X-Microsystems/xmicro-serial/README.md

# XMICRO-SERIAL

[XMICRO](https://github.com/x-microsystems/xmicro-bus) serial communications card providing two RS-232 ports and a PS/2 port.

Datasheet: [XMICRO-SERIAL](Documentation/XMICRO-SERIAL.pdf)

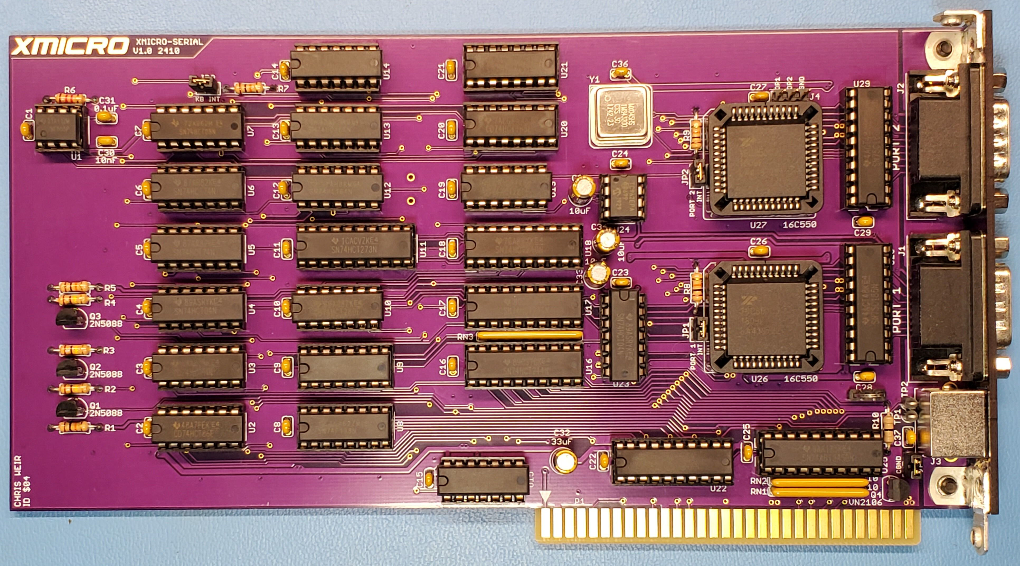
[picture p1: Images/XMICRO-SERIAL 1.jpg]
XMICRO-SERIAL
