X-Microsystems/xmicro-serial/Documentation/Schematics/Netlist.txt

Netlist

Exported from XMICRO-SERIAL V1.0.sch at 2024-09-08 19:48:15

EAGLE Version 6.3.0 Copyright (c) 1988-2012 CadSoft

Net      Part     Pad      Pin        Sheet

!BCSX    P1       9        !CSX       4
         U22      2        A          4

!BIRQX   P1       52       !IRQX      4
         Q4       3        D          6

!BRD     P1       19       !RD        4
         U22      4        A          4

!BRST    P1       10       !RST       4
         U15      5        I          4

!BWR     P1       20       !WR        4
         U22      17       A          4

!CSX     U22      18       Y          4
         U25      19       !OE        4
         U26      16       !CS2       1
         U27      16       !CS2       1
         U8       4        G2A        5
         U9       4        G2A        5

!CS_IDR  U16      1        !OE        5
         U16      19       !OE        5
         U9       7        Y7         5

!CS_KBR  U14      3        CLK        2
         U18      1        !OE        2
         U18      19       !OE        2
         U9       15       Y0         5

!CS_KBW  U20      1        SH/!LD     3
         U21      1        SH/!LD     3
         U5       10       PRE        3
         U5       3        CLK        3
         U8       15       Y0         5

!CS_STR  U17      1        !OE        5
         U17      19       !OE        5
         U9       14       Y1         5

!KB_DATA U12      1        A          2
         U15      12       O          2
         U3       9        I0         3

!KB_INT_ENABLE U23      13       I          2
         U26      38       !OP1       1

!KB_WRCYCLE U12      2        B          2
         U13      2        B          2
         U20      15       INH        3
         U21      15       INH        3
         U5       6        !Q         3

!RD      U22      16       Y          4
         U25      1        DIR        4
         U26      24       !IOR       1
         U27      24       !IOR       1
         U9       5        G2B        5

!RST     U11      1        CLR        2
         U15      2        O          4
         U5       13       CLR        3
         U6       1        CLR        2
         U7       1        I0         2
         U7       4        I0         2

!WR      U22      3        Y          4
         U26      20       !IOW       1
         U27      20       !IOW       1
         U8       5        G2B        5

+5V      C1       1        1          6
         C10      1        1          6
         C11      1        1          6
         C12      1        1          6
         C13      1        1          6
         C14      1        1          6
         C15      1        1          6
         C16      1        1          6
         C17      1        1          6
         C18      1        1          6
         C19      1        1          6
         C2       1        1          6
         C20      1        1          6
         C21      1        1          6
         C22      1        1          6
         C23      1        1          6
         C25      1        1          6
         C26      1        1          6
         C27      1        1          6
         C28      1        1          6
         C29      1        1          6
         C3       1        1          6
         C32      +        +          6
         C36      1        1          6
         C37      1        1          6
         C4       1        1          6
         C5       1        1          6
         C6       1        1          6
         C7       1        1          6
         C8       1        1          6
         C9       1        1          6
         J3       4        4          2
         P1       5        +5V        4
         P1       6        +5V        4
         R1       2        2          2
         R5       2        2          2
         R6       1        1          3
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
         C9       2        2          6
         J1       5        5          1
         J2       5        5          1
         J3       3        3          2
         J4       1        1          1
         JP4      1        1          6
         P1       21       0V         4
         P1       3        0V         4
         P1       4        0V         4
         P1       42       0V         4
         P1       62       0V         4
         Q1       1        E          3
         Q2       1        E          2
         Q3       1        E          3
         Q4       1        S          6
         R7       2        2          6
         R8       1        1          6
         R9       1        1          6
         U1       1        GND        3
         U10      1        G          2
         U10      7        0V         * none *
         U11      10       0V         * none *
         U12      7        0V         * none *
         U13      7        0V         * none *
         U14      7        0V         * none *
         U15      7        0V         * none *
         U16      10       0V         * none *
         U16      11       A          5
         U16      13       A          5
         U16      15       A          5
         U16      17       A          5
         U16      2        A          5
         U16      6        A          5
         U16      8        A          5
         U17      10       0V         * none *
         U17      17       A          5
         U17      2        A          5
         U17      4        A          5
         U18      10       0V         * none *
         U19      7        0V         * none *
         U19      8        A          3
         U2       7        0V         * none *
         U20      5        G          3
         U20      6        H          3
         U20      8        0V         * none *
         U21      8        0V         * none *
         U22      1        !OE        4
         U22      10       0V         * none *
         U22      19       !OE        4
         U23      7        0V         * none *
         U24      3        0V         1
         U25      10       0V         * none *
         U26      21       IOW        1
         U26      22       0V         * none *
         U26      25       IOR        1
         U26      28       !AS        1
         U27      21       IOW        1
         U27      22       0V         * none *
         U27      25       IOR        1
         U27      28       !AS        1
         U28      11       0V         1
         U29      11       0V         1
         U3       7        0V         * none *
         U4       7        0V         * none *
         U5       7        0V         * none *
         U6       7        0V         * none *
         U7       7        0V         * none *
         U8       8        0V         * none *
         U9       8        0V         * none *
         Y1       4        0V         1

A0       U22      5        Y          4
         U26      31       A0         1
         U27      31       A0         1
         U8       1        A          5
         U9       1        A          5

A1       U22      14       Y          4
         U26      30       A1         1
         U27      30       A1         1
         U8       2        B          5
         U9       2        B          5

A2       U22      7        Y          4
         U26      29       A2         1
         U27      29       A2         1
         U8       3        C          5
         U9       3        C          5

A3       U22      12       Y          4
         U23      1        I          1
         U27      14       CS0        1

A4       U22      9        Y          4
         U23      3        I          1
         U8       6        G1         5
         U9       6        G1         5

BA0      P1       22       A0         4
         U22      15       A          4

BA1      P1       23       A1         4
         U22      6        A          4

BA2      P1       24       A2         4
         U22      13       A          4

BA3      P1       25       A3         4
         U22      8        A          4

BA4      P1       26       A4         4
         U22      11       A          4

BUFF_KB_CLOCK U12      8        CLK        2
         U13      8        CLK        2
         U15      8        O          2
         U20      2        CLK        3
         U21      2        CLK        3
         U4       11       I          2
         U5       11       CLK        3

CGND     J1       S1       S          1
         J1       S2       S          1
         J2       S1       S          1
         J2       S2       S          1
         J3       G$1      SHIELD     2
         J3       G$2      SHIELD     2
         J3       G$3      SHIELD     2
         JP4      2        2          6

D0       RN3      2        2          4
         U16      18       Y          5
         U17      18       Y          5
         U18      18       Y          2
         U19      1        G          3
         U20      4        F          3
         U25      18       B1         4
         U26      2        D0         1
         U27      2        D0         1

D1       RN3      3        3          4
         U16      3        Y          5
         U17      3        Y          5
         U18      3        Y          2
         U19      13       F          3
         U20      3        E          3
         U25      17       B2         4
         U26      3        D1         1
         U27      3        D1         1

D2       RN3      4        4          4
         U16      16       Y          5
         U17      16       Y          5
         U18      16       Y          2
         U19      2        H          3
         U20      14       D          3
         U25      16       B3         4
         U26      4        D2         1
         U27      4        D2         1

D3       RN3      5        5          4
         U16      5        Y          5
         U17      5        Y          5
         U18      5        Y          2
         U19      12       E          3
         U20      13       C          3
         U25      15       B4         4
         U26      5        D3         1
         U27      5        D3         1

D4       RN3      6        6          4
         U16      14       Y          5
         U17      14       Y          5
         U18      14       Y          2
         U19      11       D          3
         U20      12       B          3
         U25      14       B5         4
         U26      6        D4         1
         U27      6        D4         1

D5       RN3      7        7          4
         U16      7        Y          5
         U17      7        Y          5
         U18      7        Y          2
         U19      4        I          3
         U20      11       A          3
         U25      13       B6         4
         U26      7        D5         1
         U27      7        D5         1

D6       RN3      8        8          4
         U16      12       Y          5
         U17      12       Y          5
         U18      12       Y          2
         U19      10       C          3
         U21      6        H          3
         U25      12       B7         4
         U26      8        D6         1
         U27      8        D6         1

D7       RN3      9        9          4
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
         U1       5        CON        3

RST      U15      1        I          4
         U15      6        O          4
         U26      39       RESET      1
         U27      39       RESET      1

UC4      U11      8        D4         2
         U12      10       QE         2
