X-Microsystems/xmicro-serial/Images/XMICRO-SERIAL 2.jpg

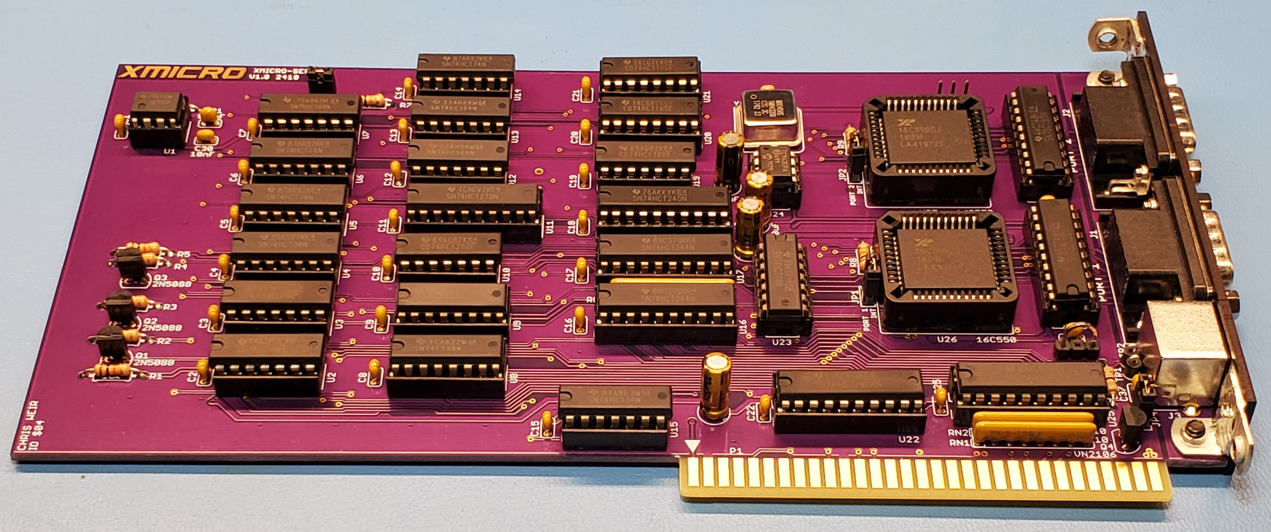
Images/XMICRO-SERIAL 2.jpg
