X-Microsystems/xmicro-serial/Images/XMICRO-SERIAL 3.jpg

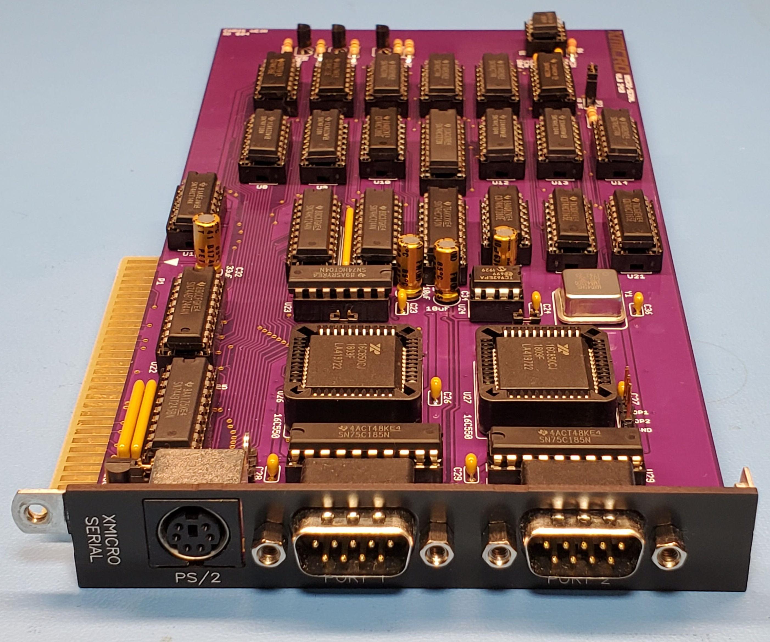
Images/XMICRO-SERIAL 3.jpg
