X-Microsystems/xmicro-serial/Documentation/Schematics/XMICRO-SERIAL V1.0 Black Large.pdf

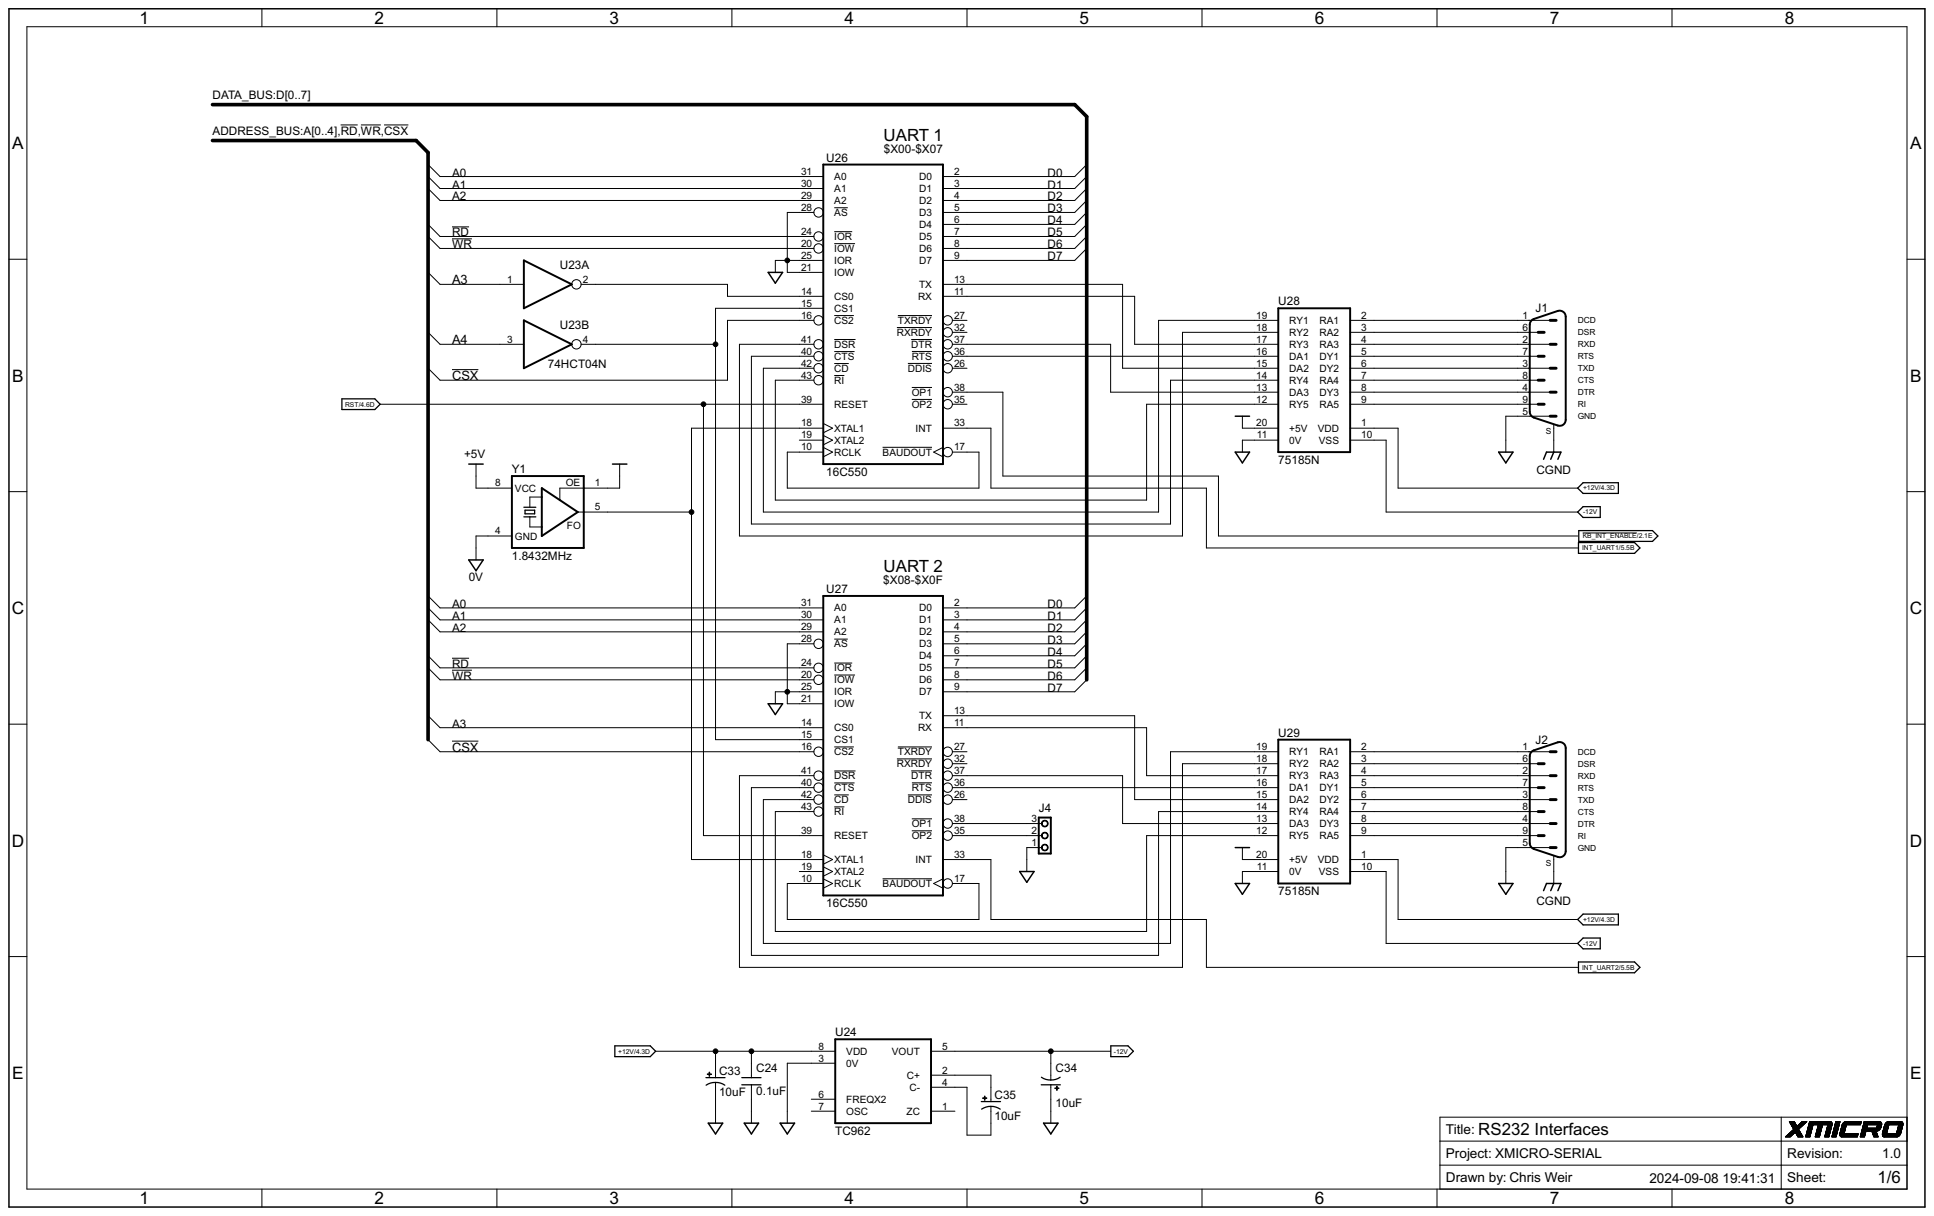
[picture p10: page 1]

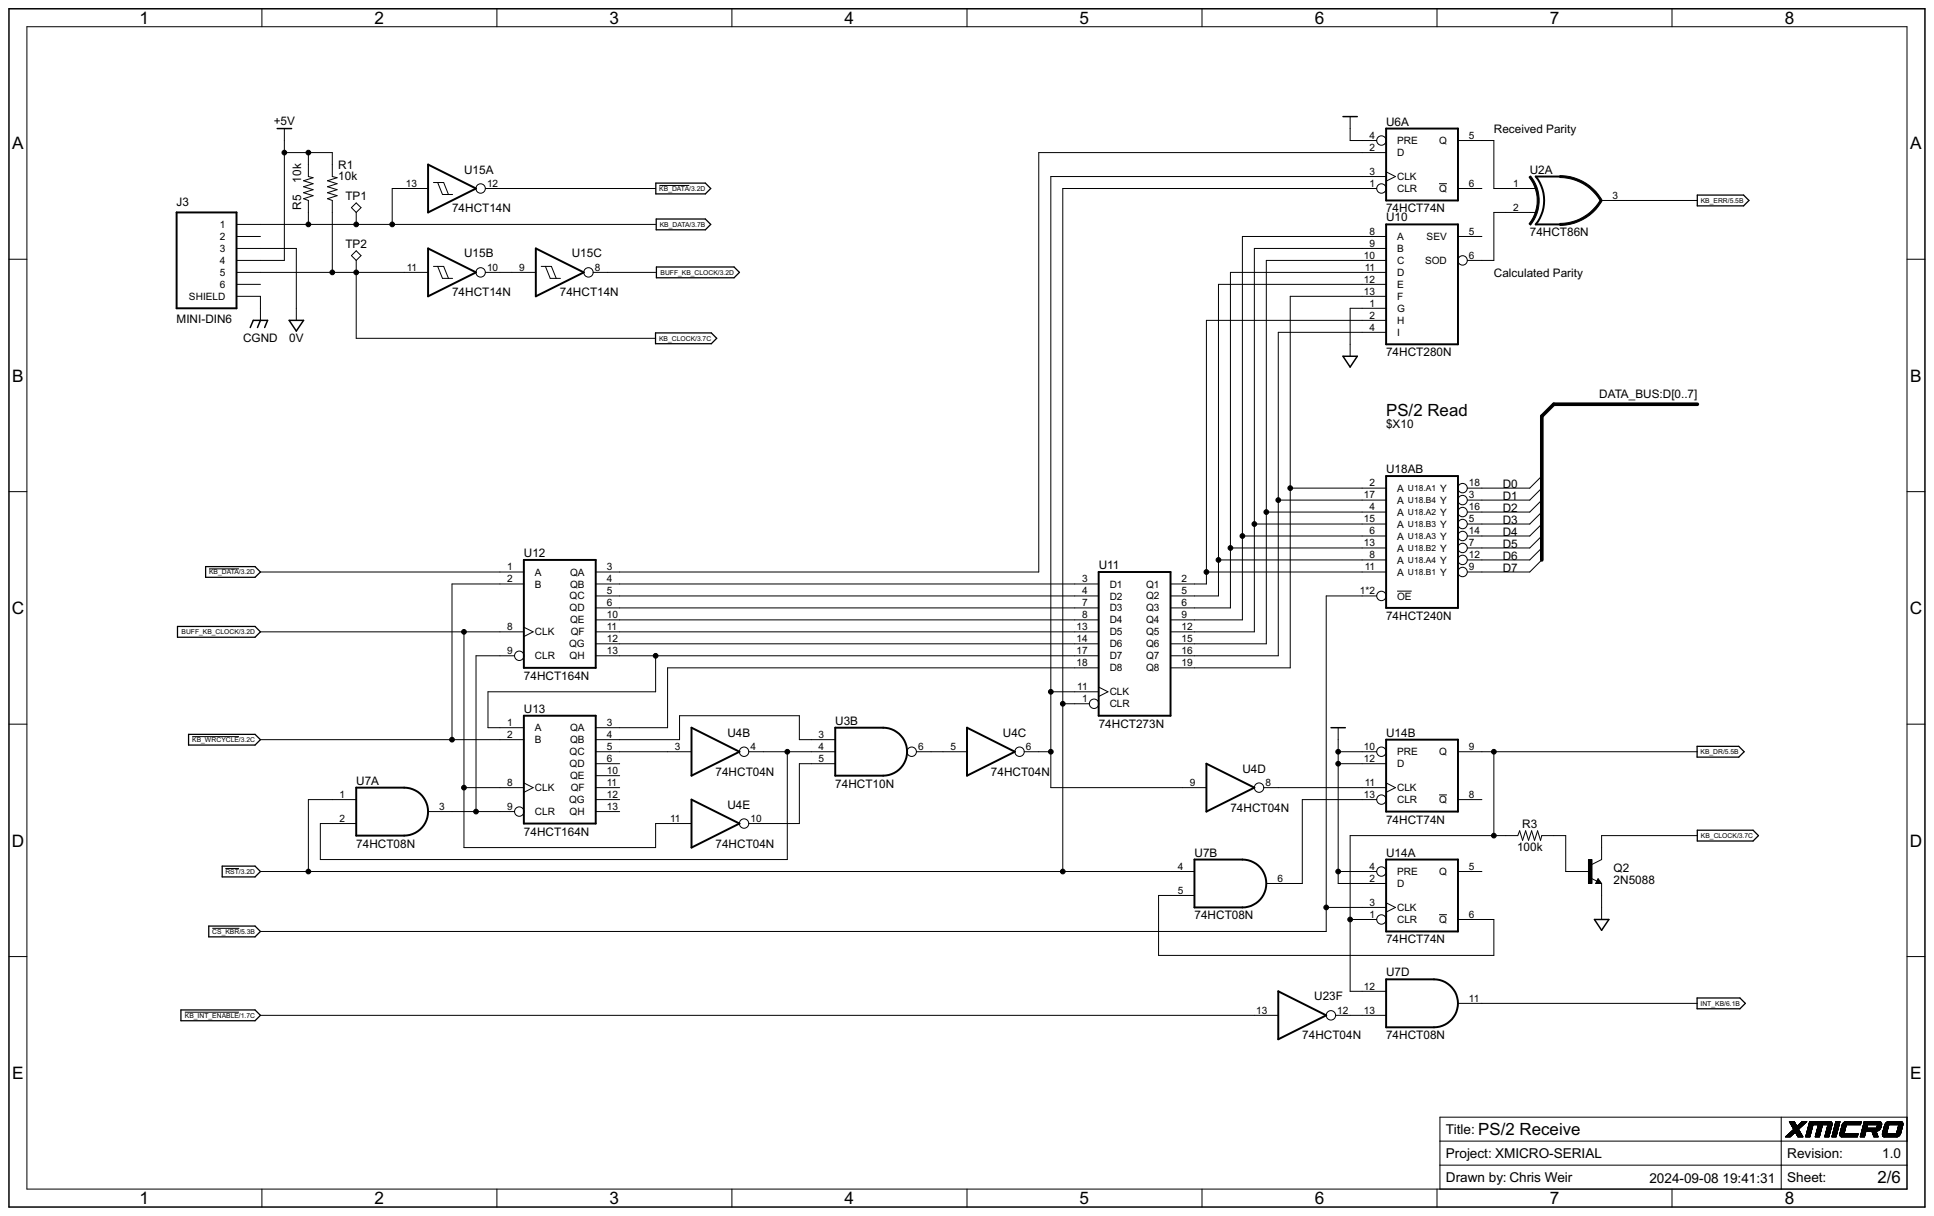
[picture p11: page 2]

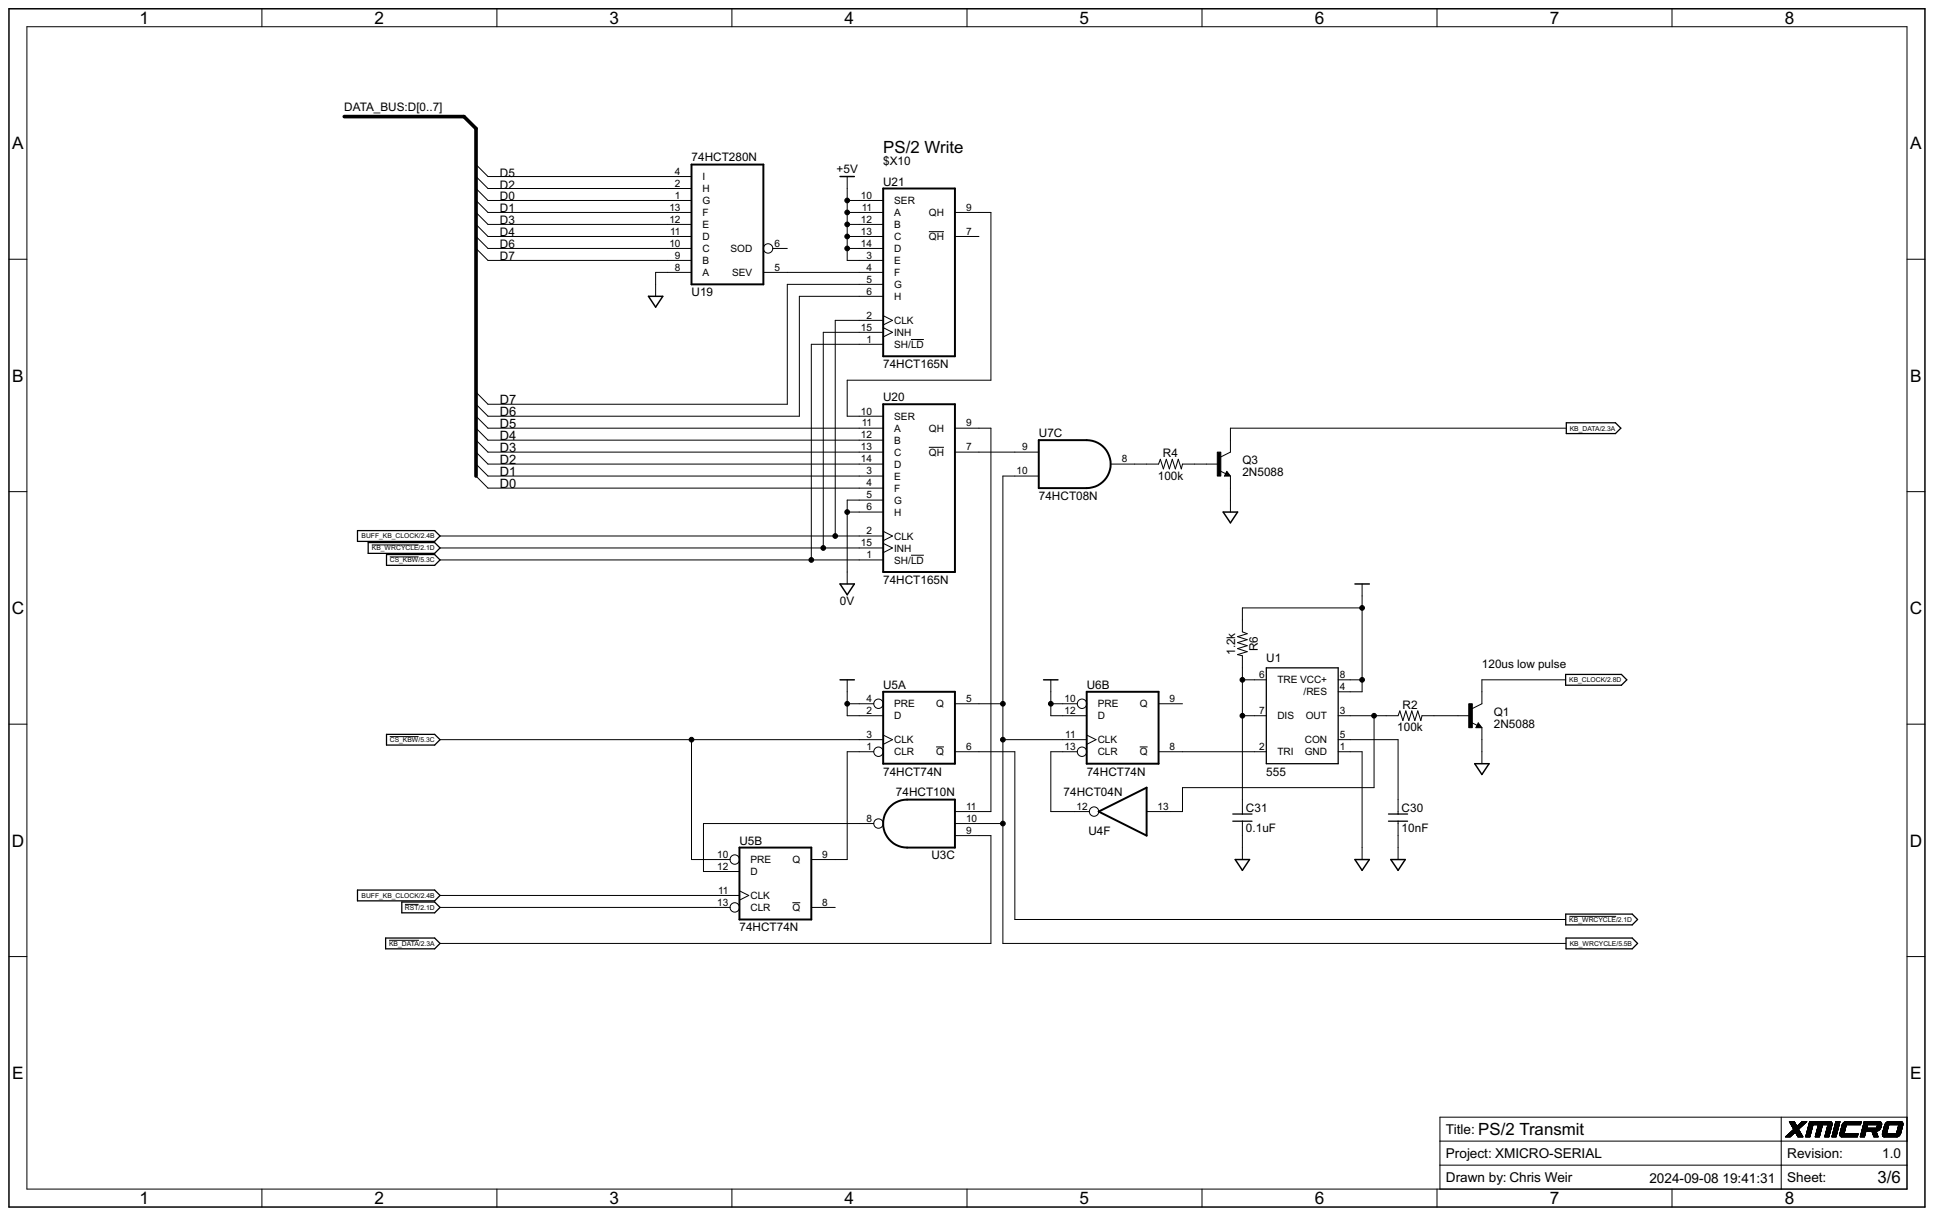
[picture p12: page 3]
