X-Microsystems/xmicro-serial/Documentation/Schematics/XMICRO-SERIAL V1.0 Black.pdf

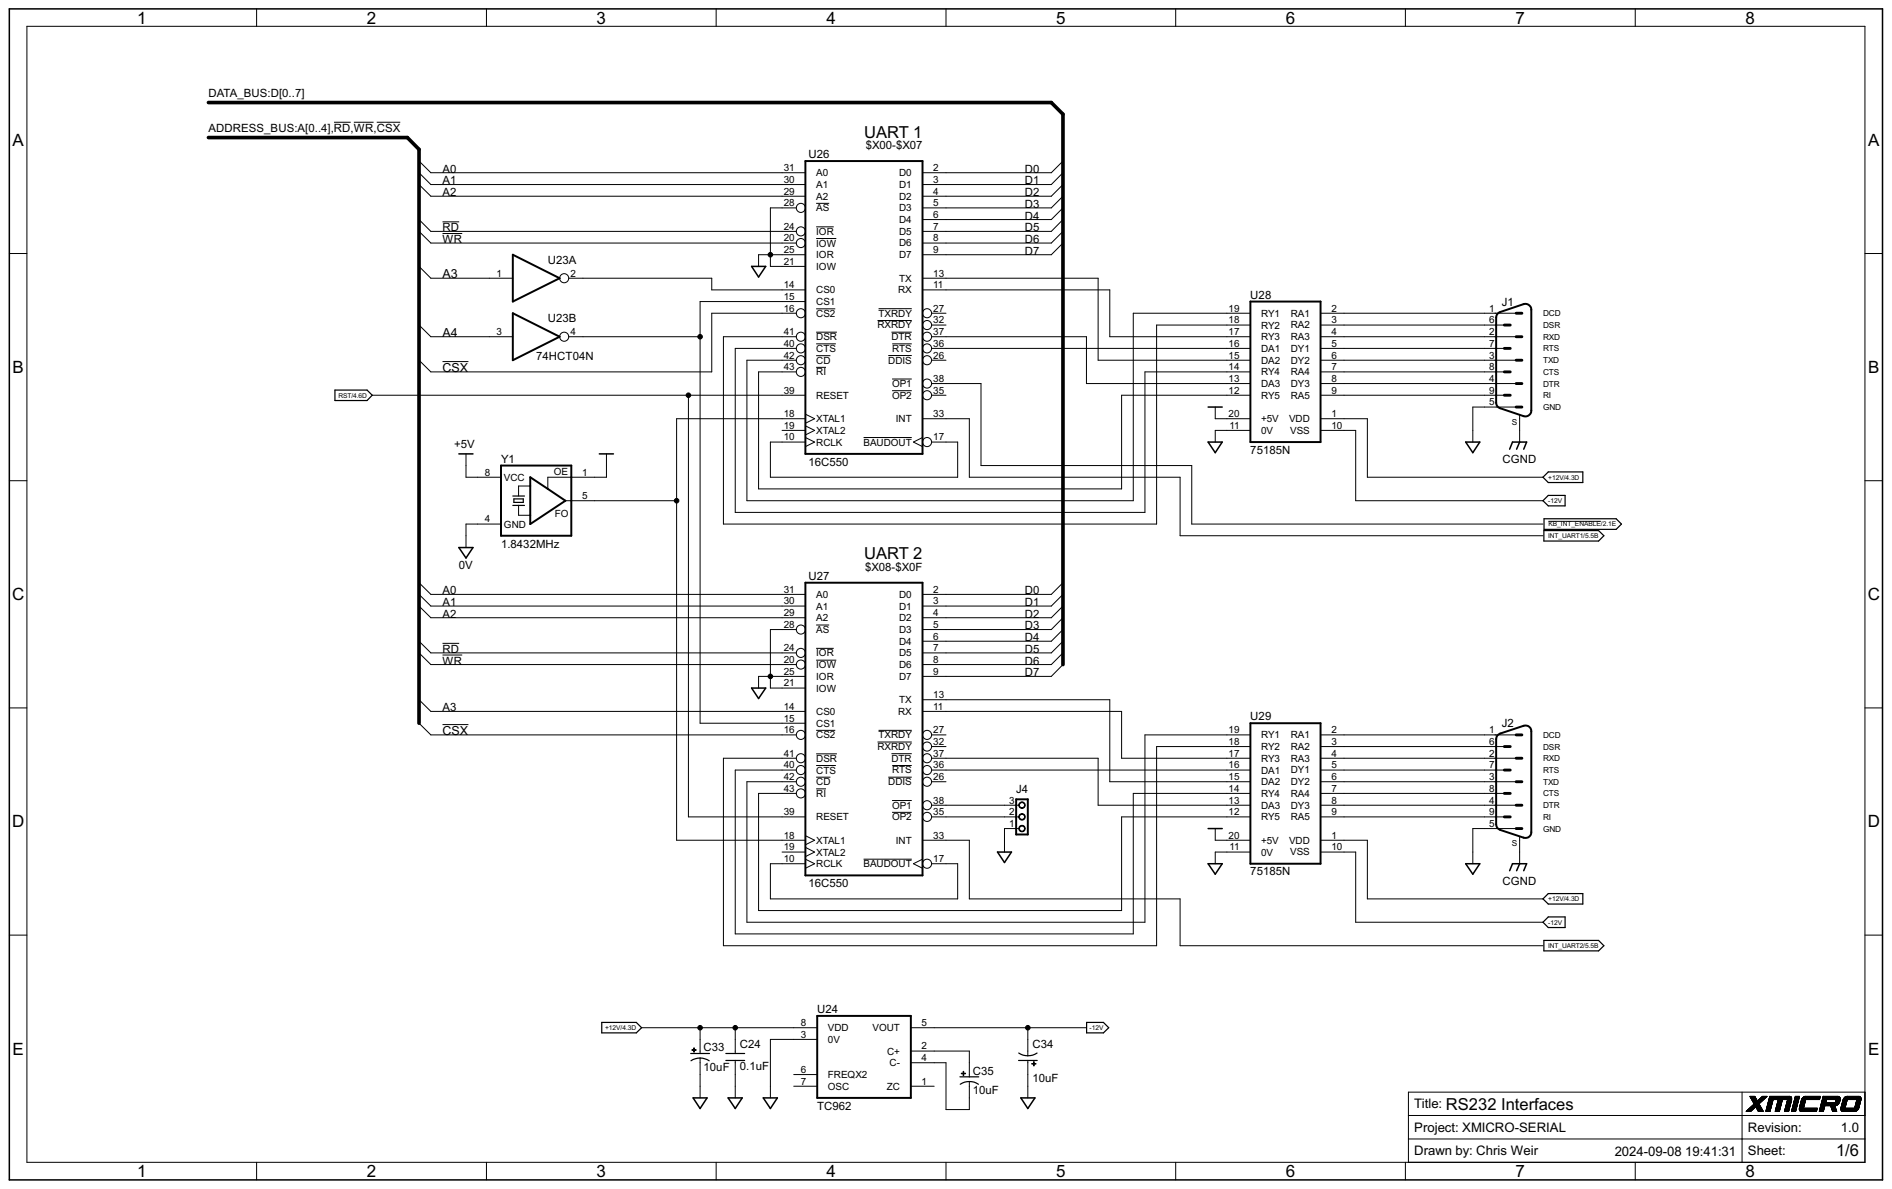
[picture p13: page 1]

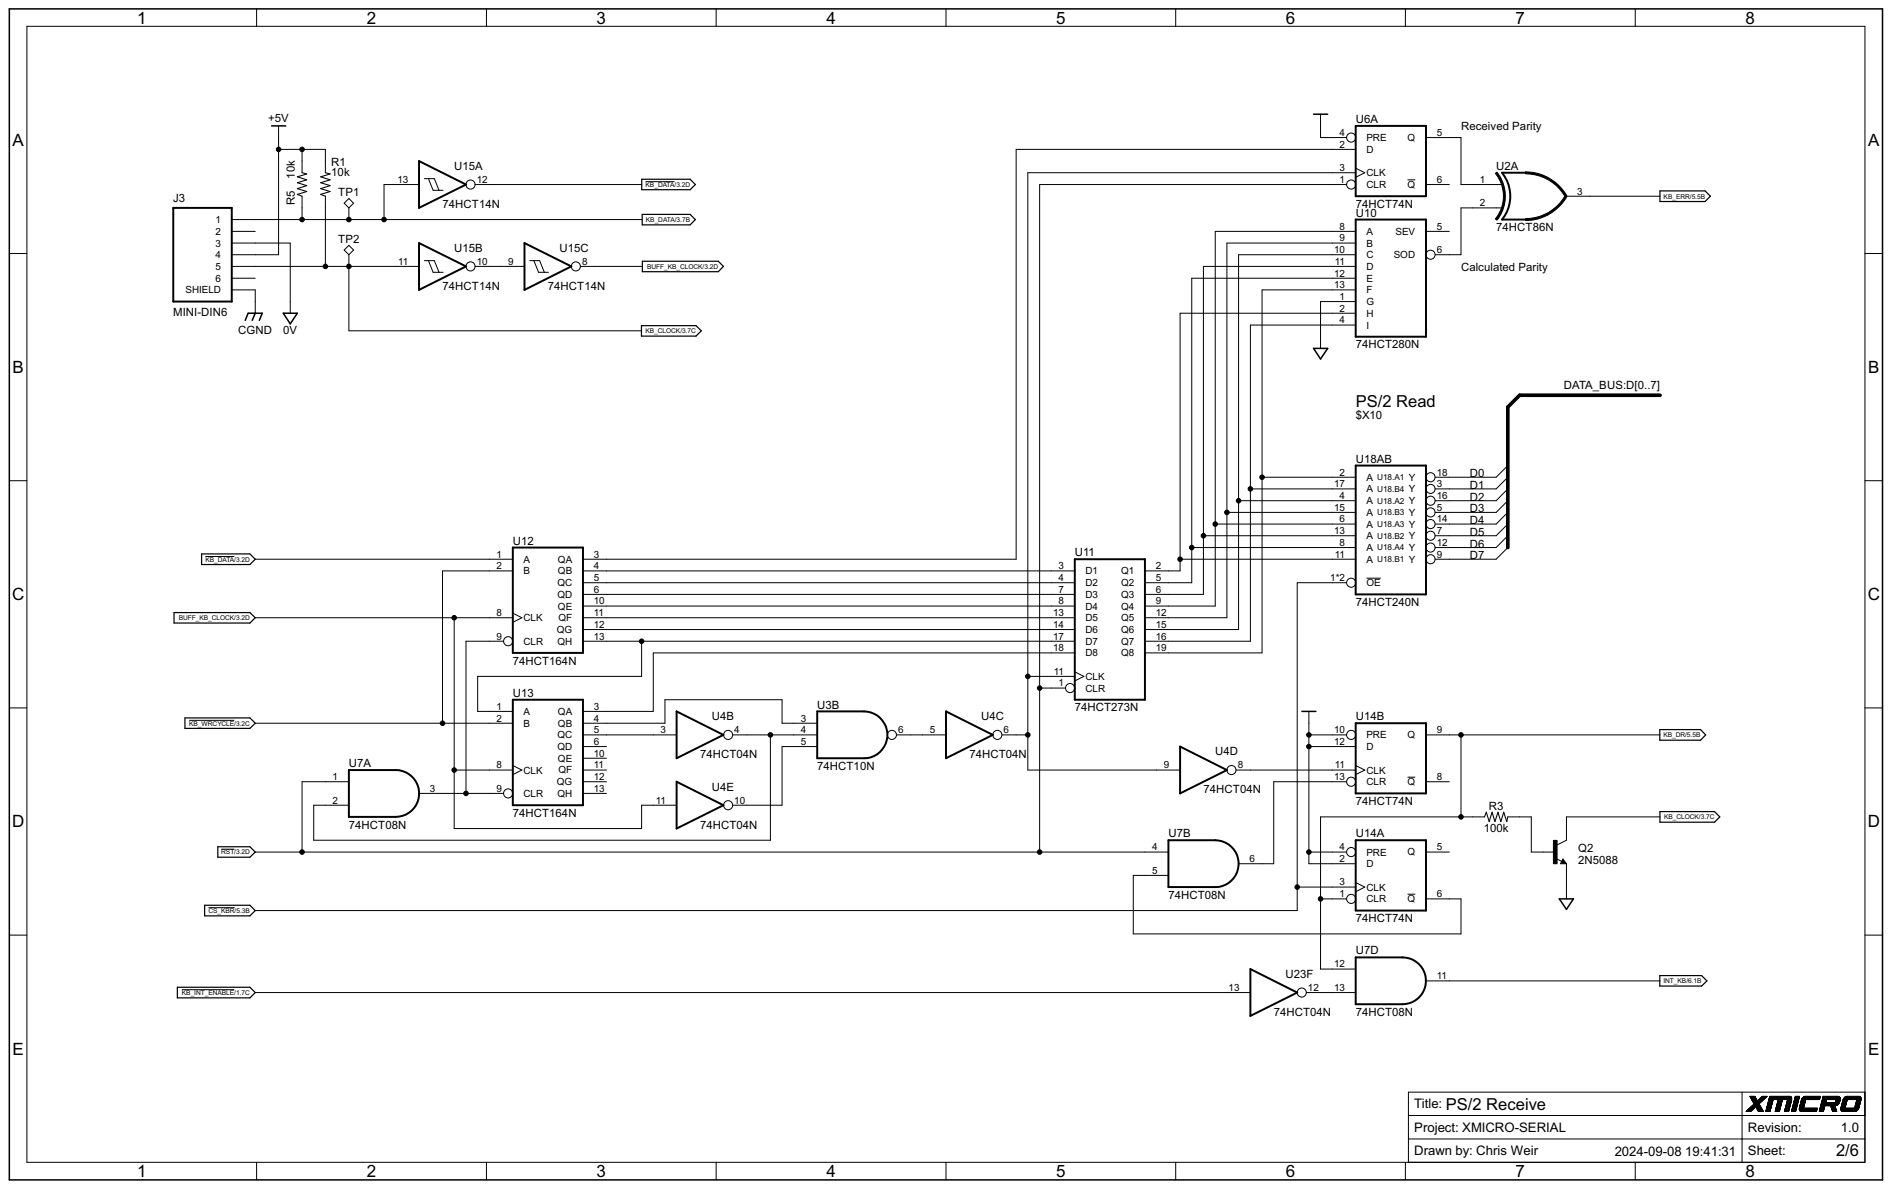
[picture p14: page 2]

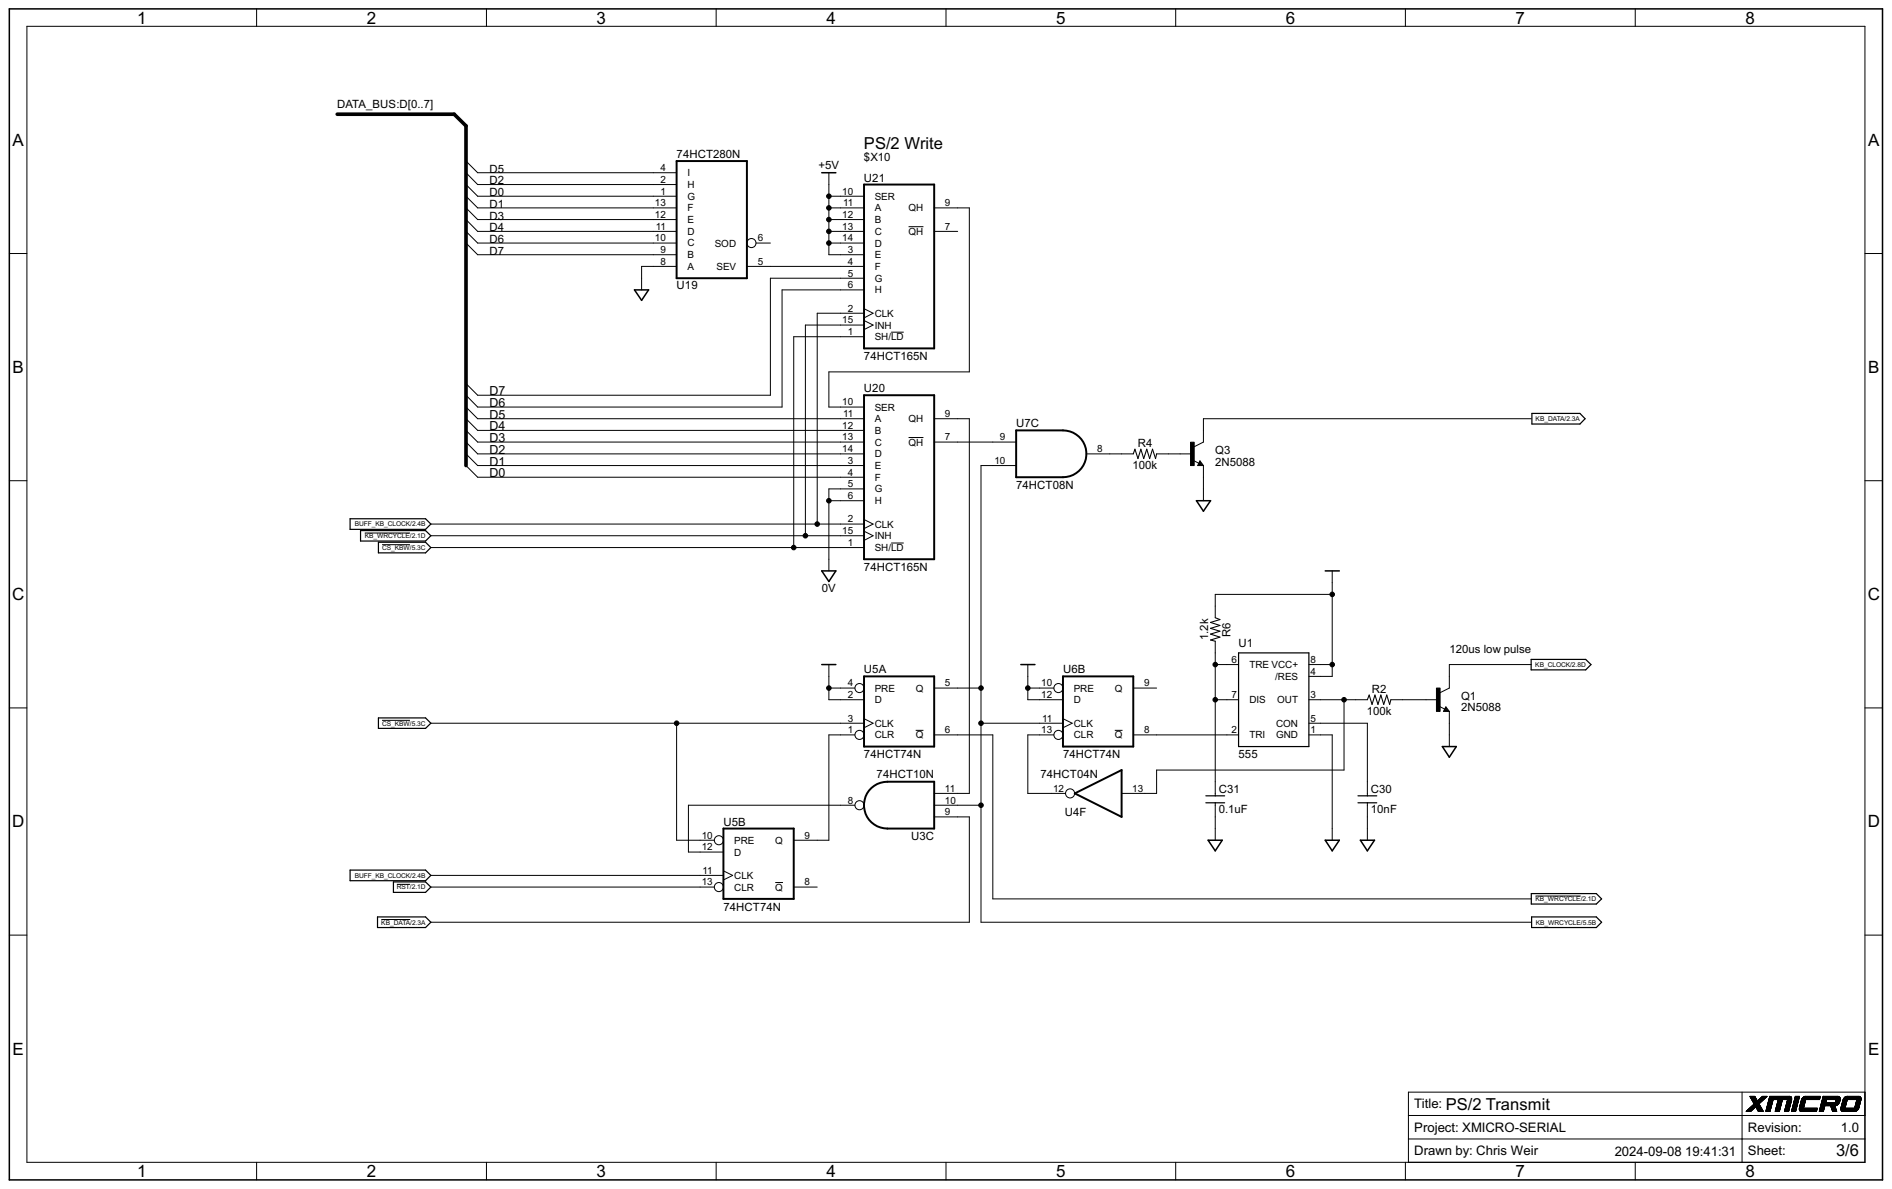
[picture p15: page 3]

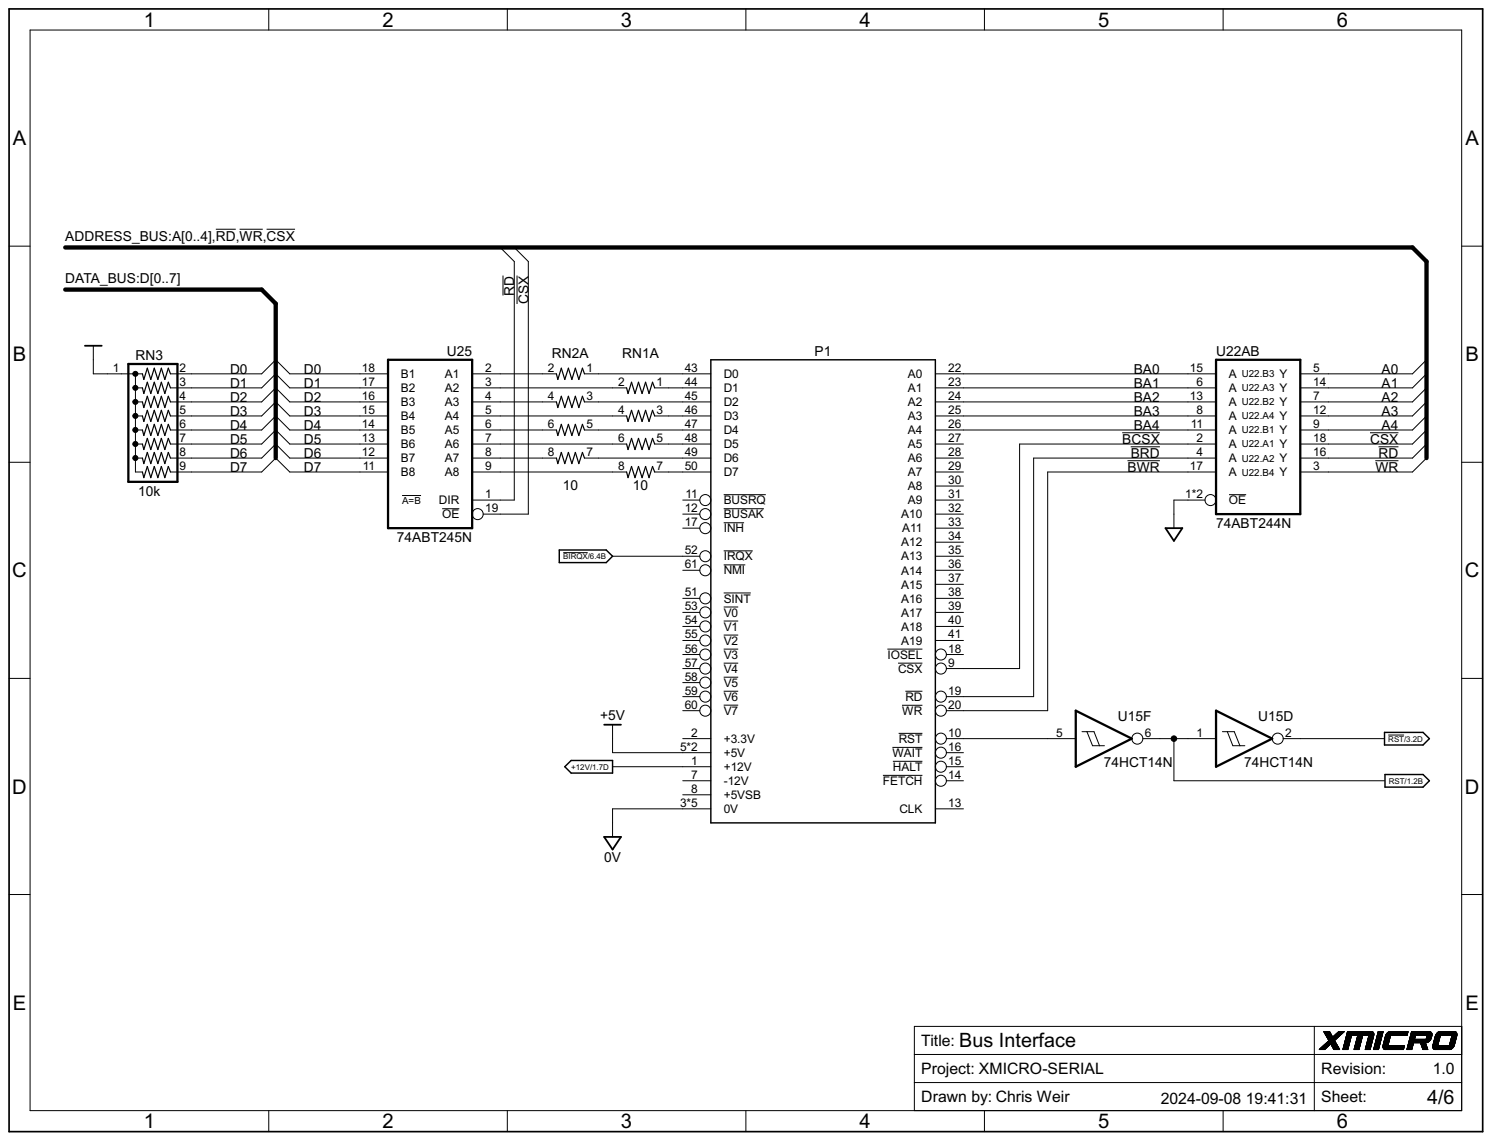
[picture p16: page 4]

Title: Project: Drawn by: Bus Interface XMICRO-SERIAL | Revision: Chris Weir Sheet: 4/6 1.0

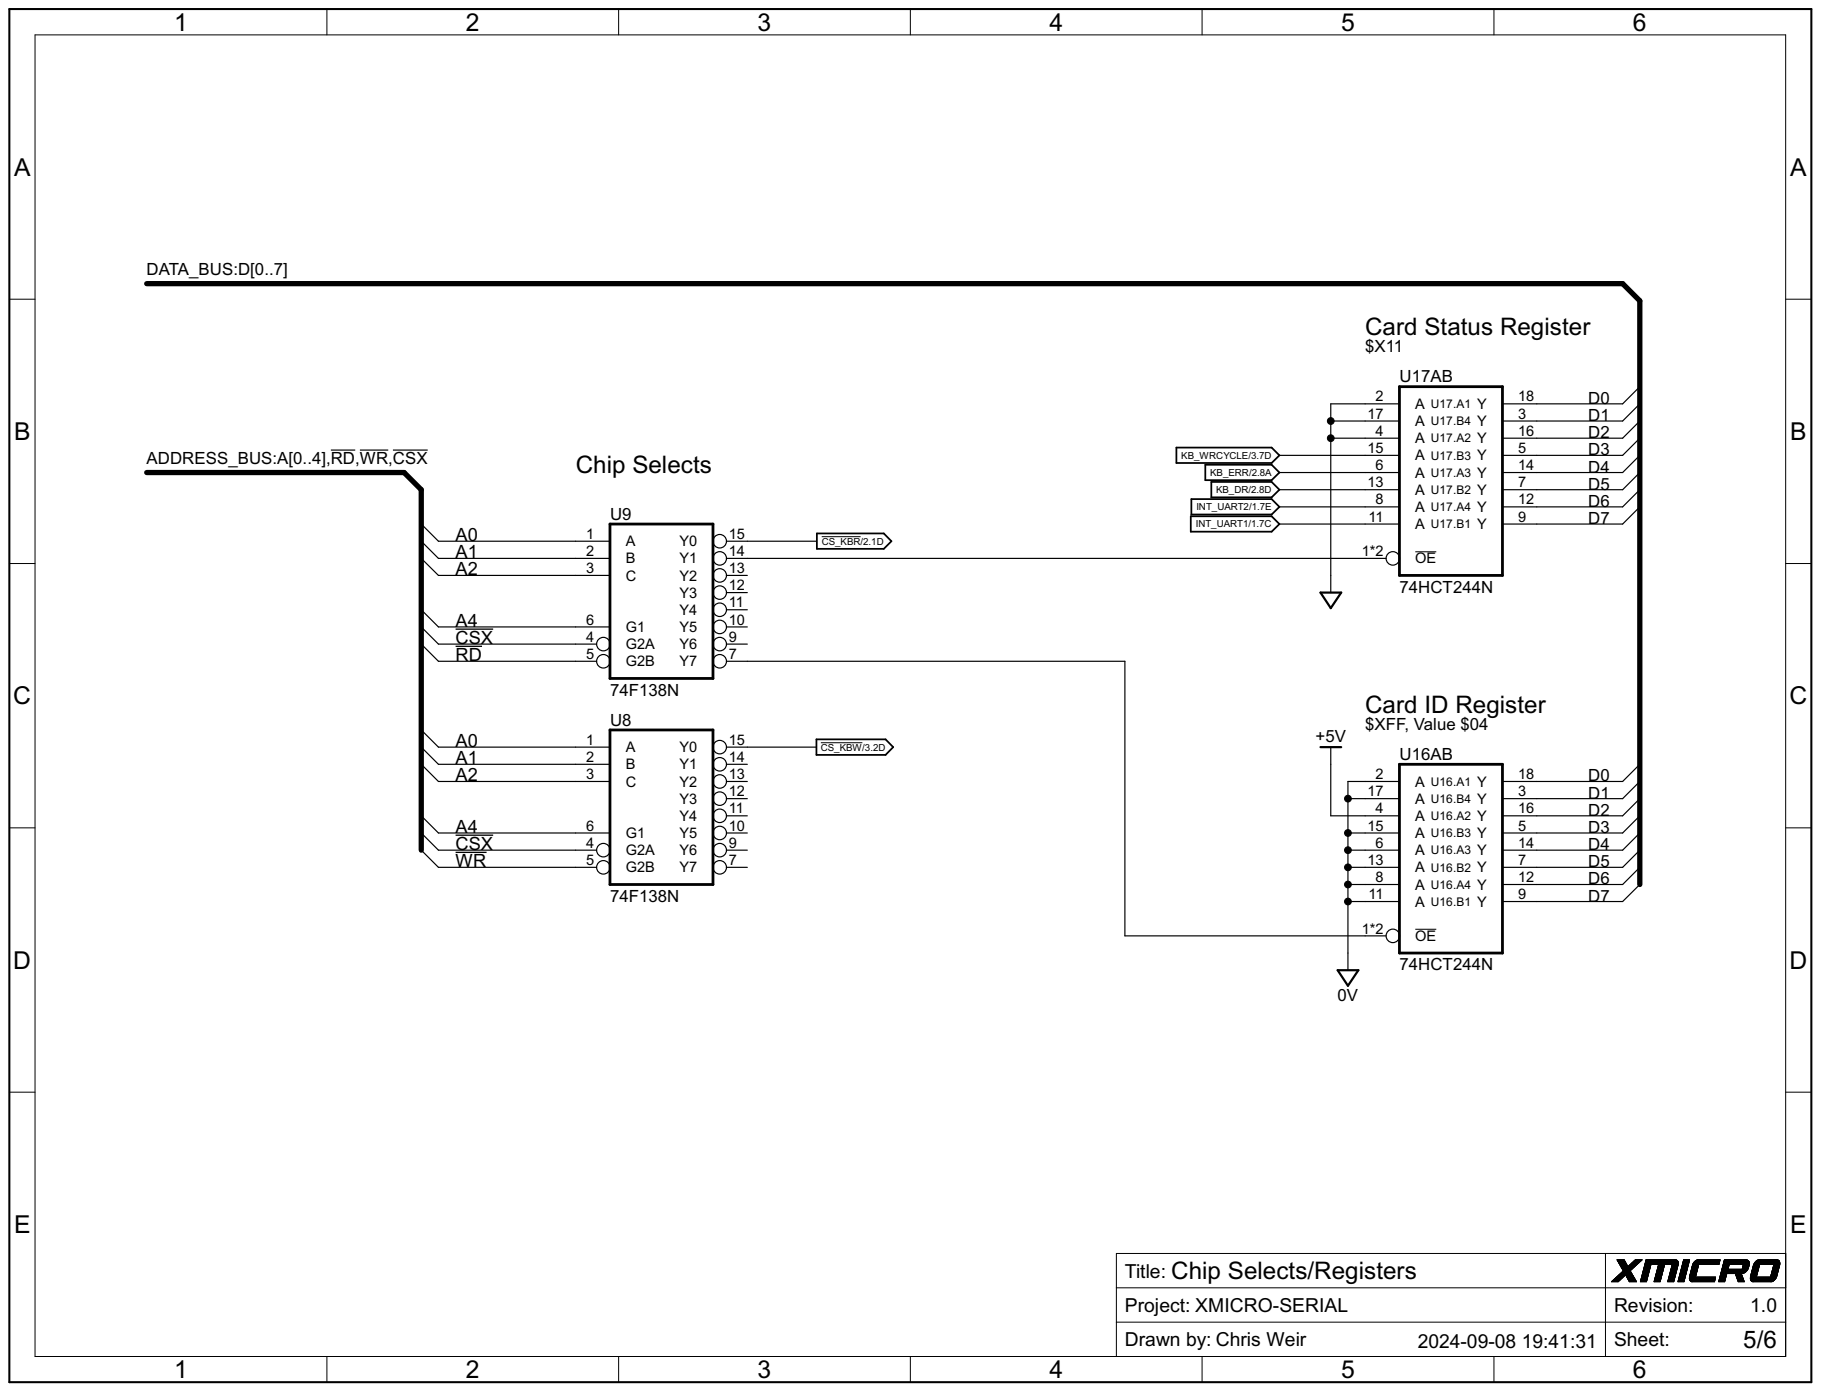
[picture p17: page 5]

Drawn by: Chip Selects/Registers

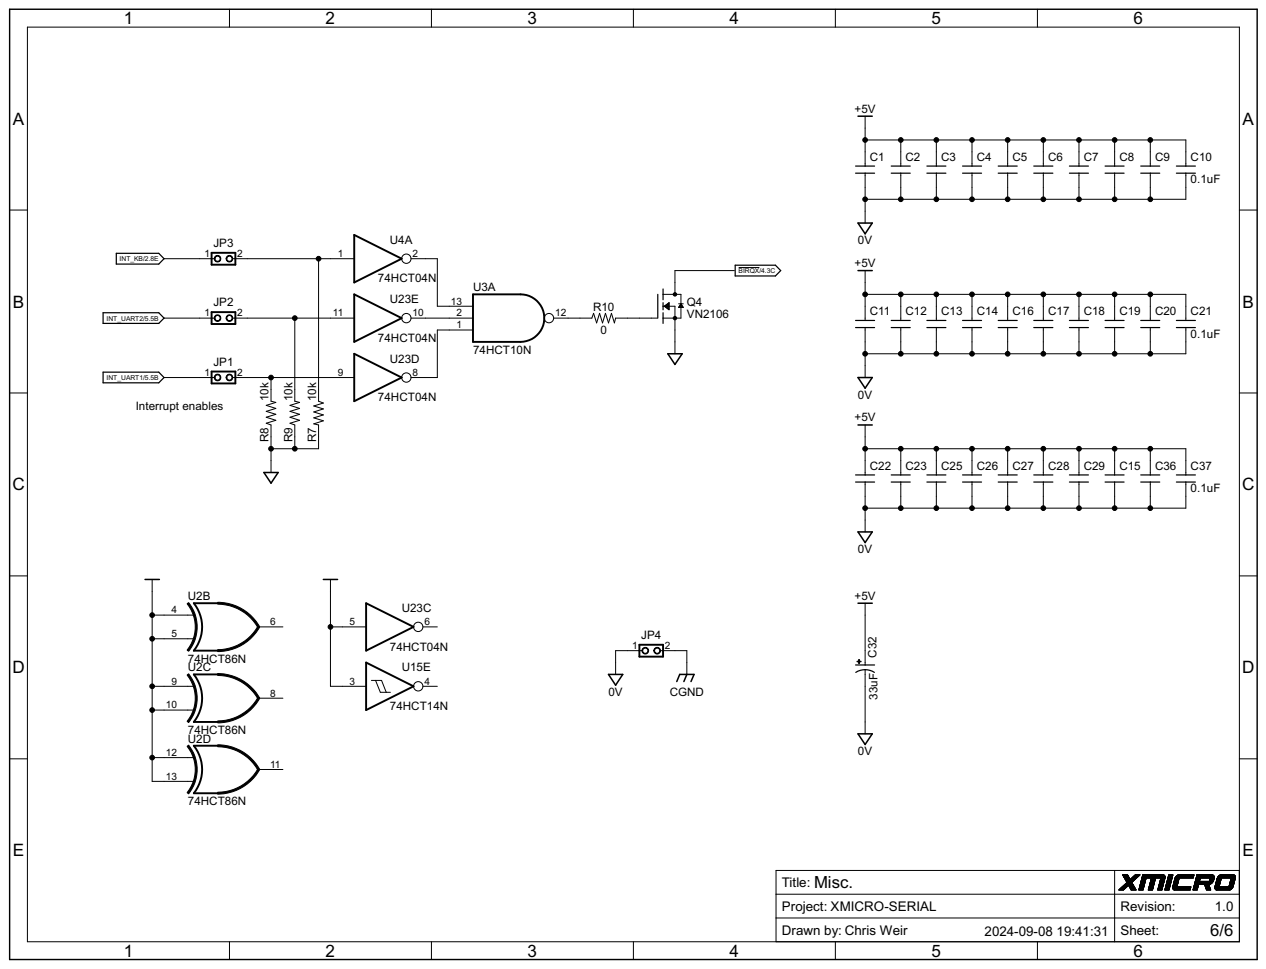
[picture p18: page 6]
