X-Microsystems/xmicro-serial/Documentation/Schematics/XMICRO-SERIAL V1.0 Color Large.pdf

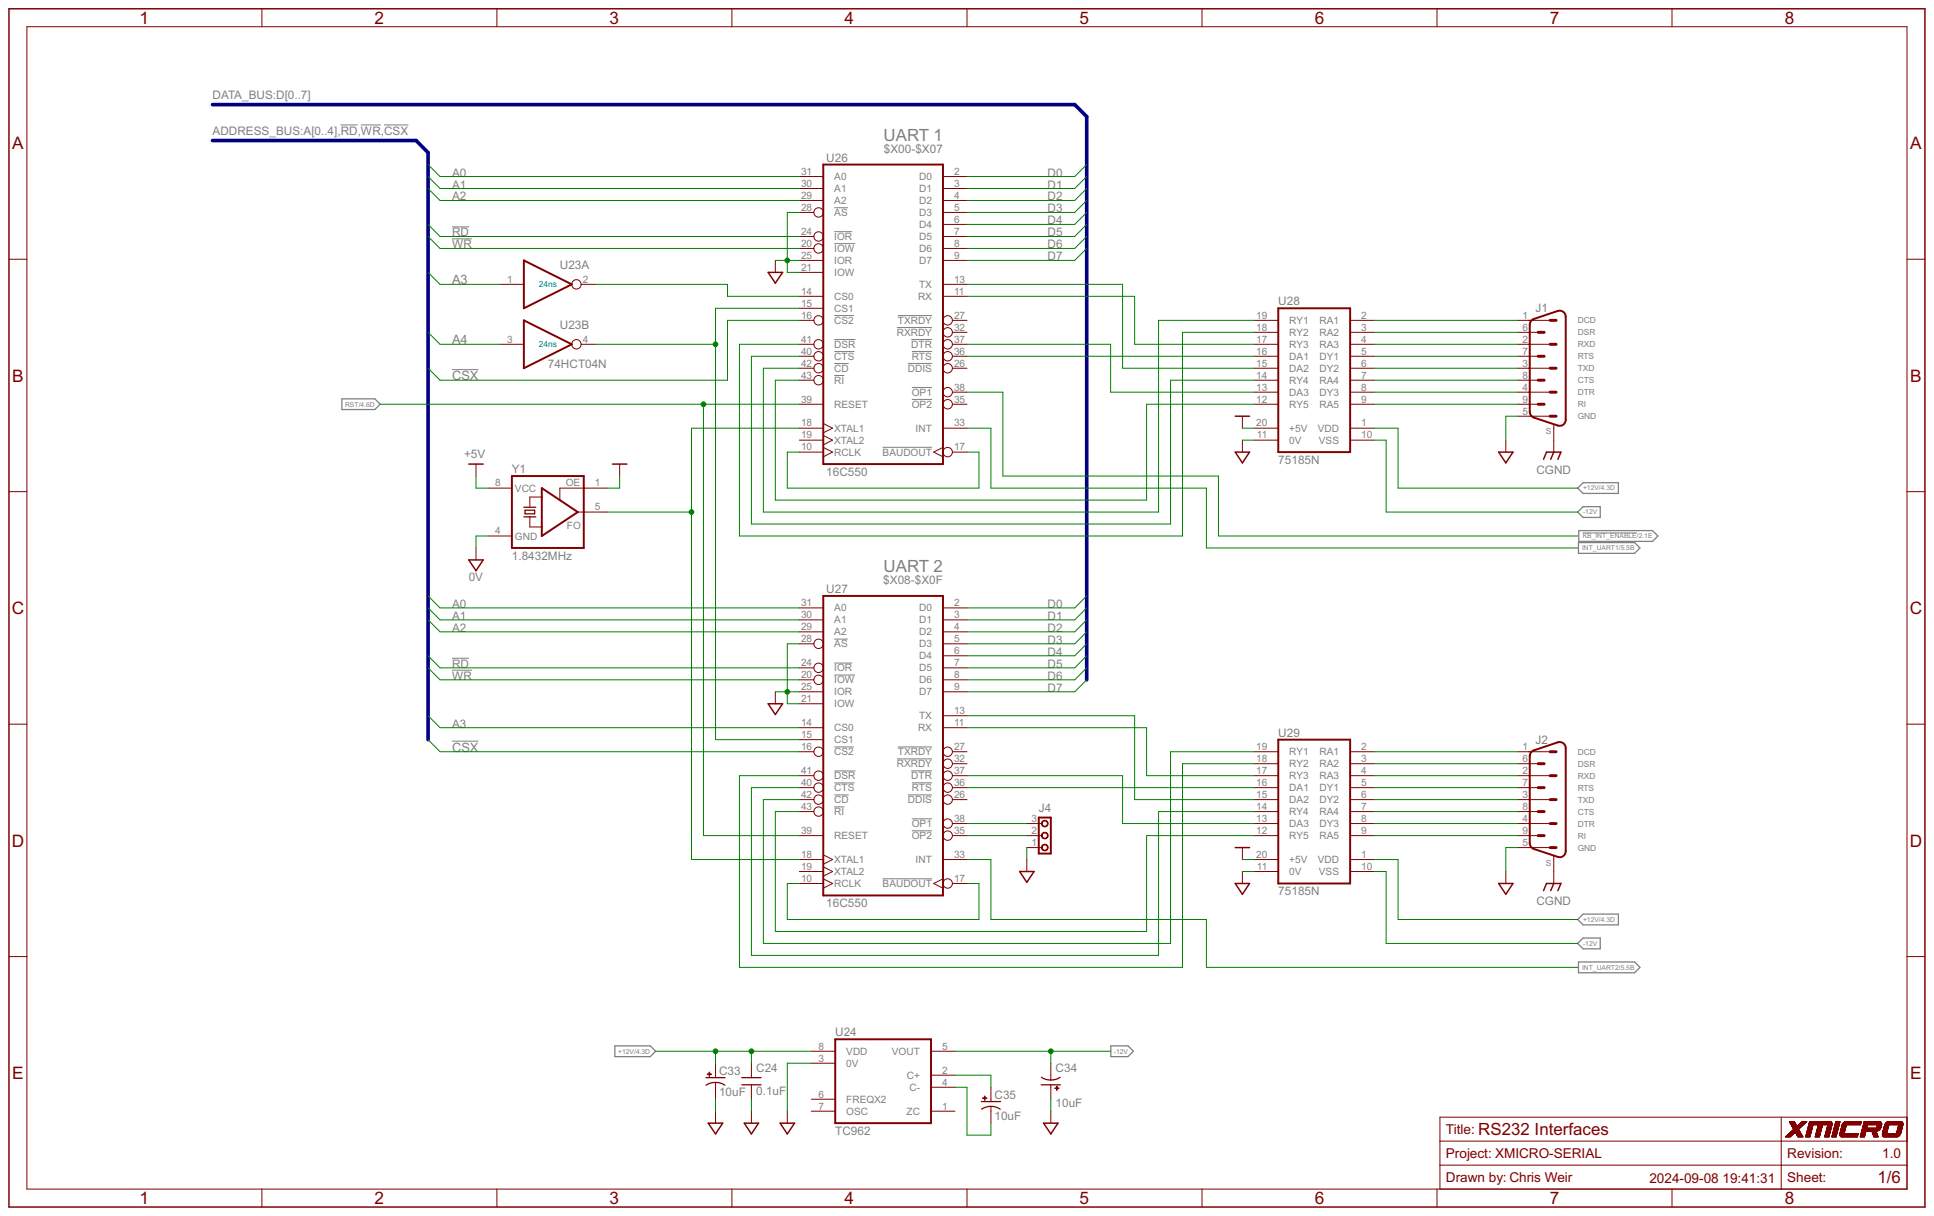
[picture p19: page 1]

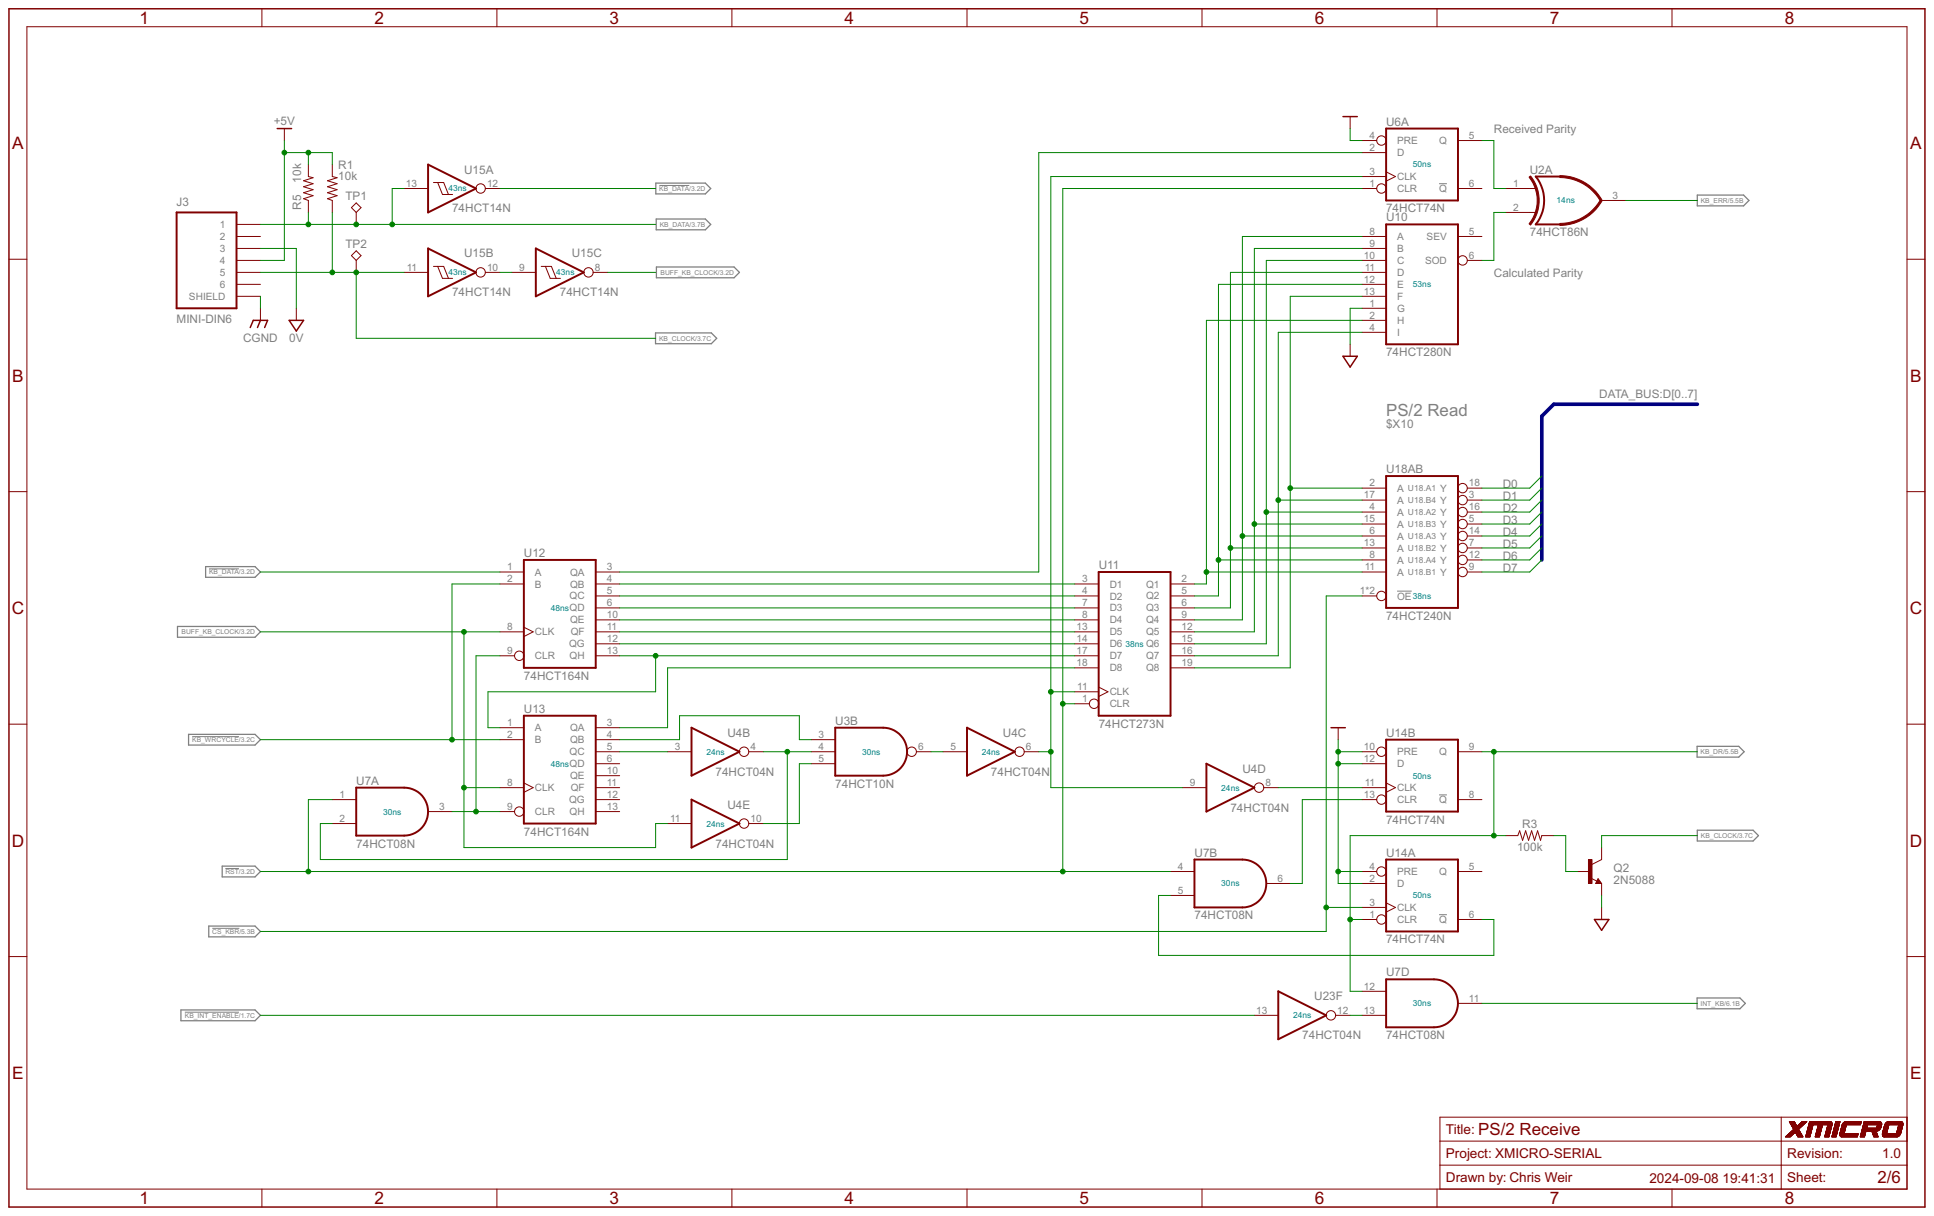
[picture p20: page 2]

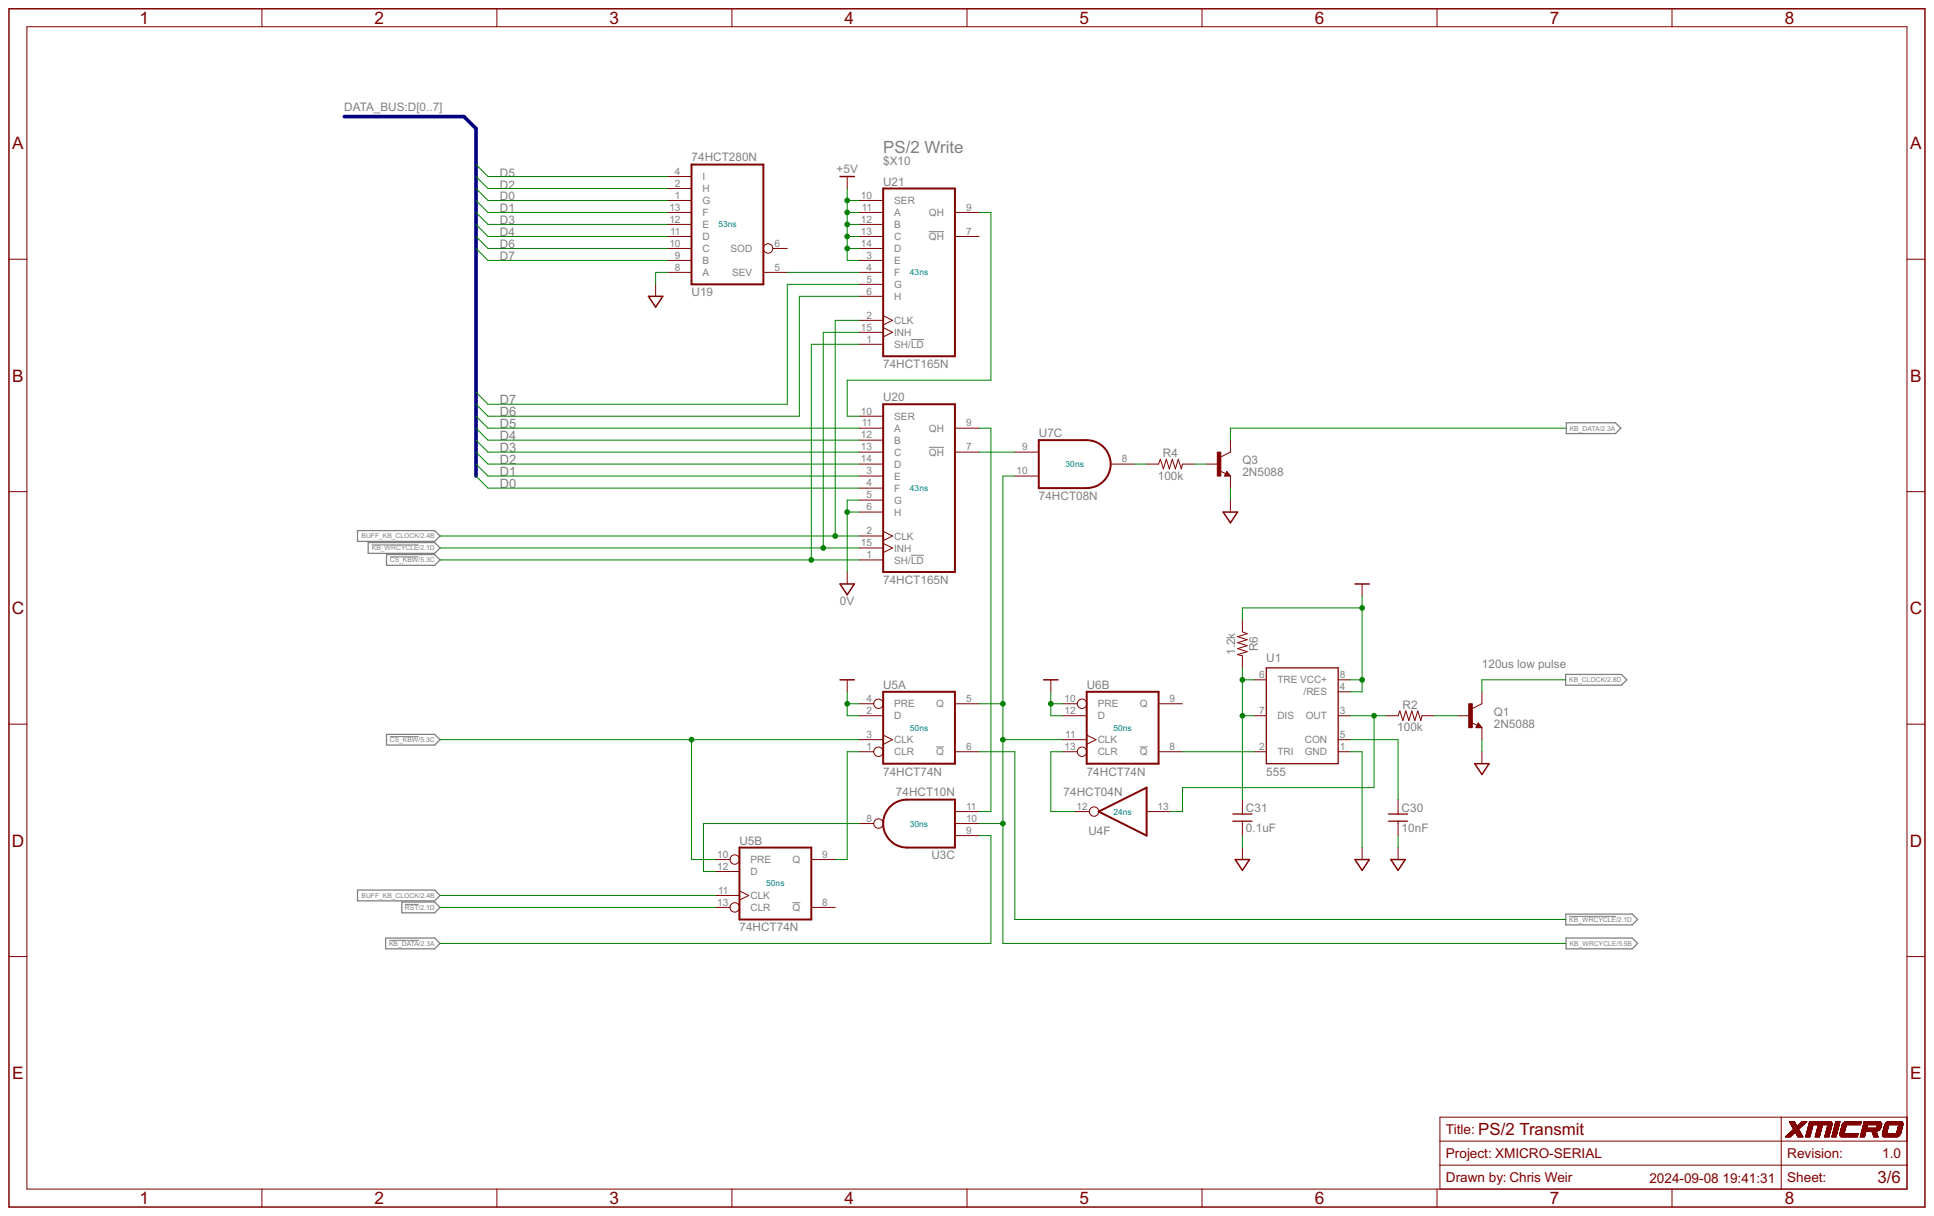
[picture p21: page 3]
