X-Microsystems/xmicro-serial/Documentation/Schematics/XMICRO-SERIAL V1.0 Color.pdf

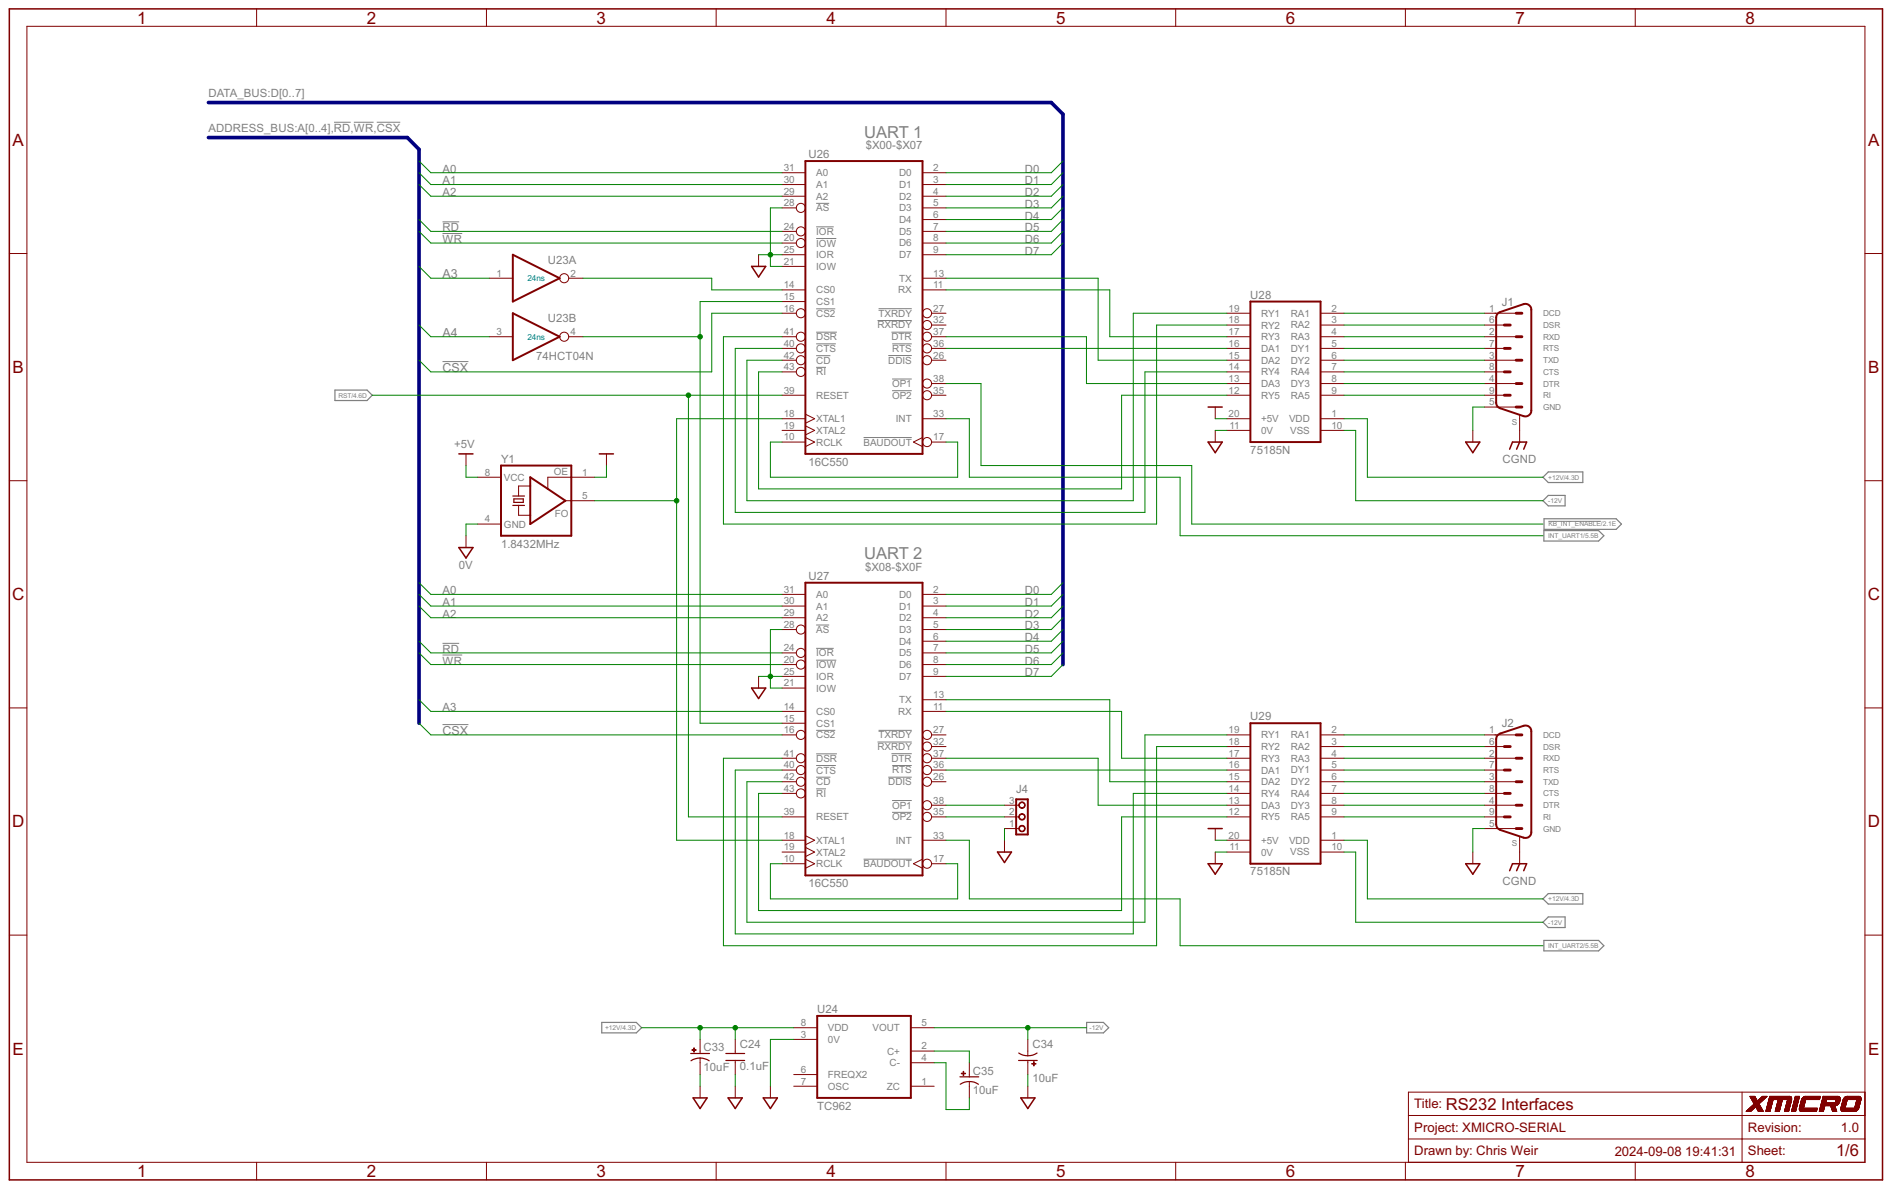
[picture p22: page 1]

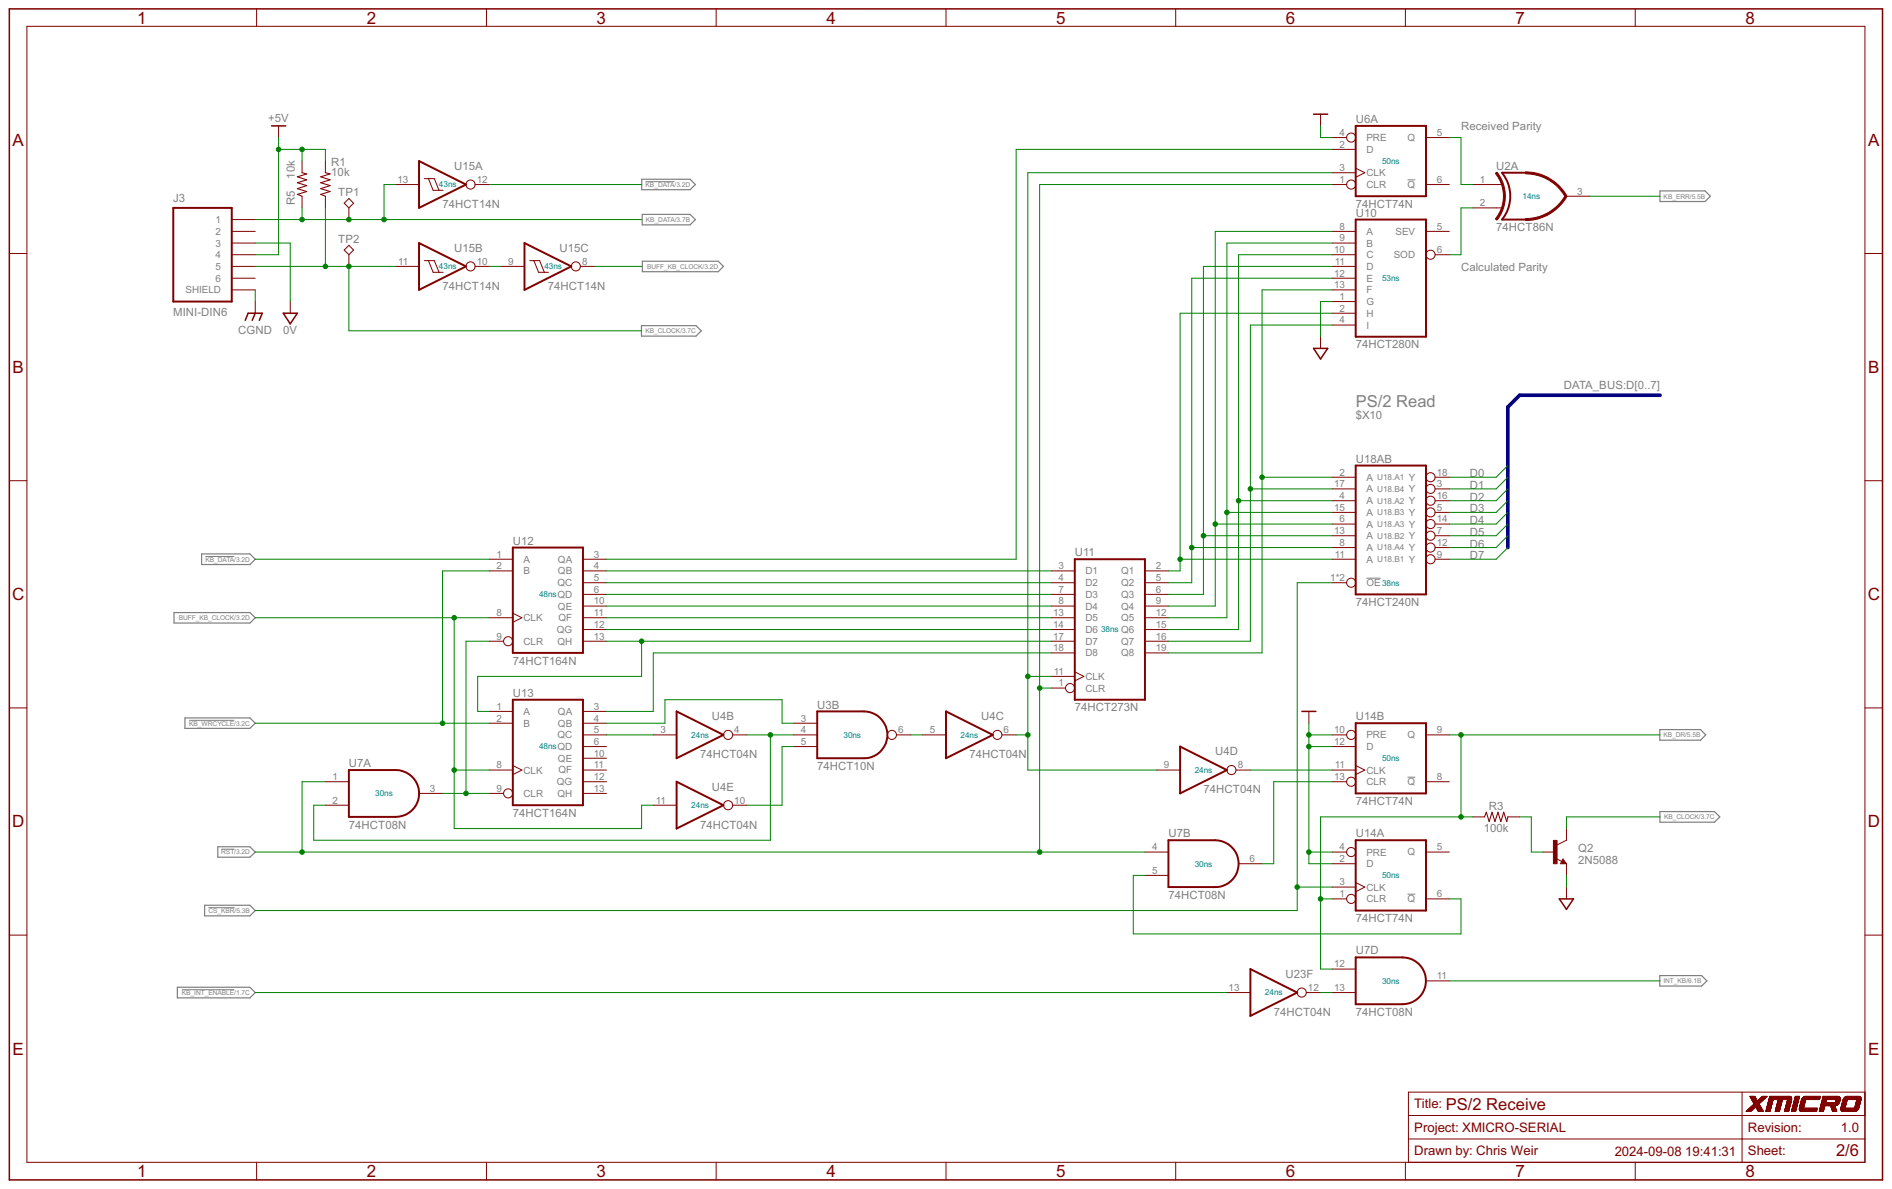
[picture p23: page 2]

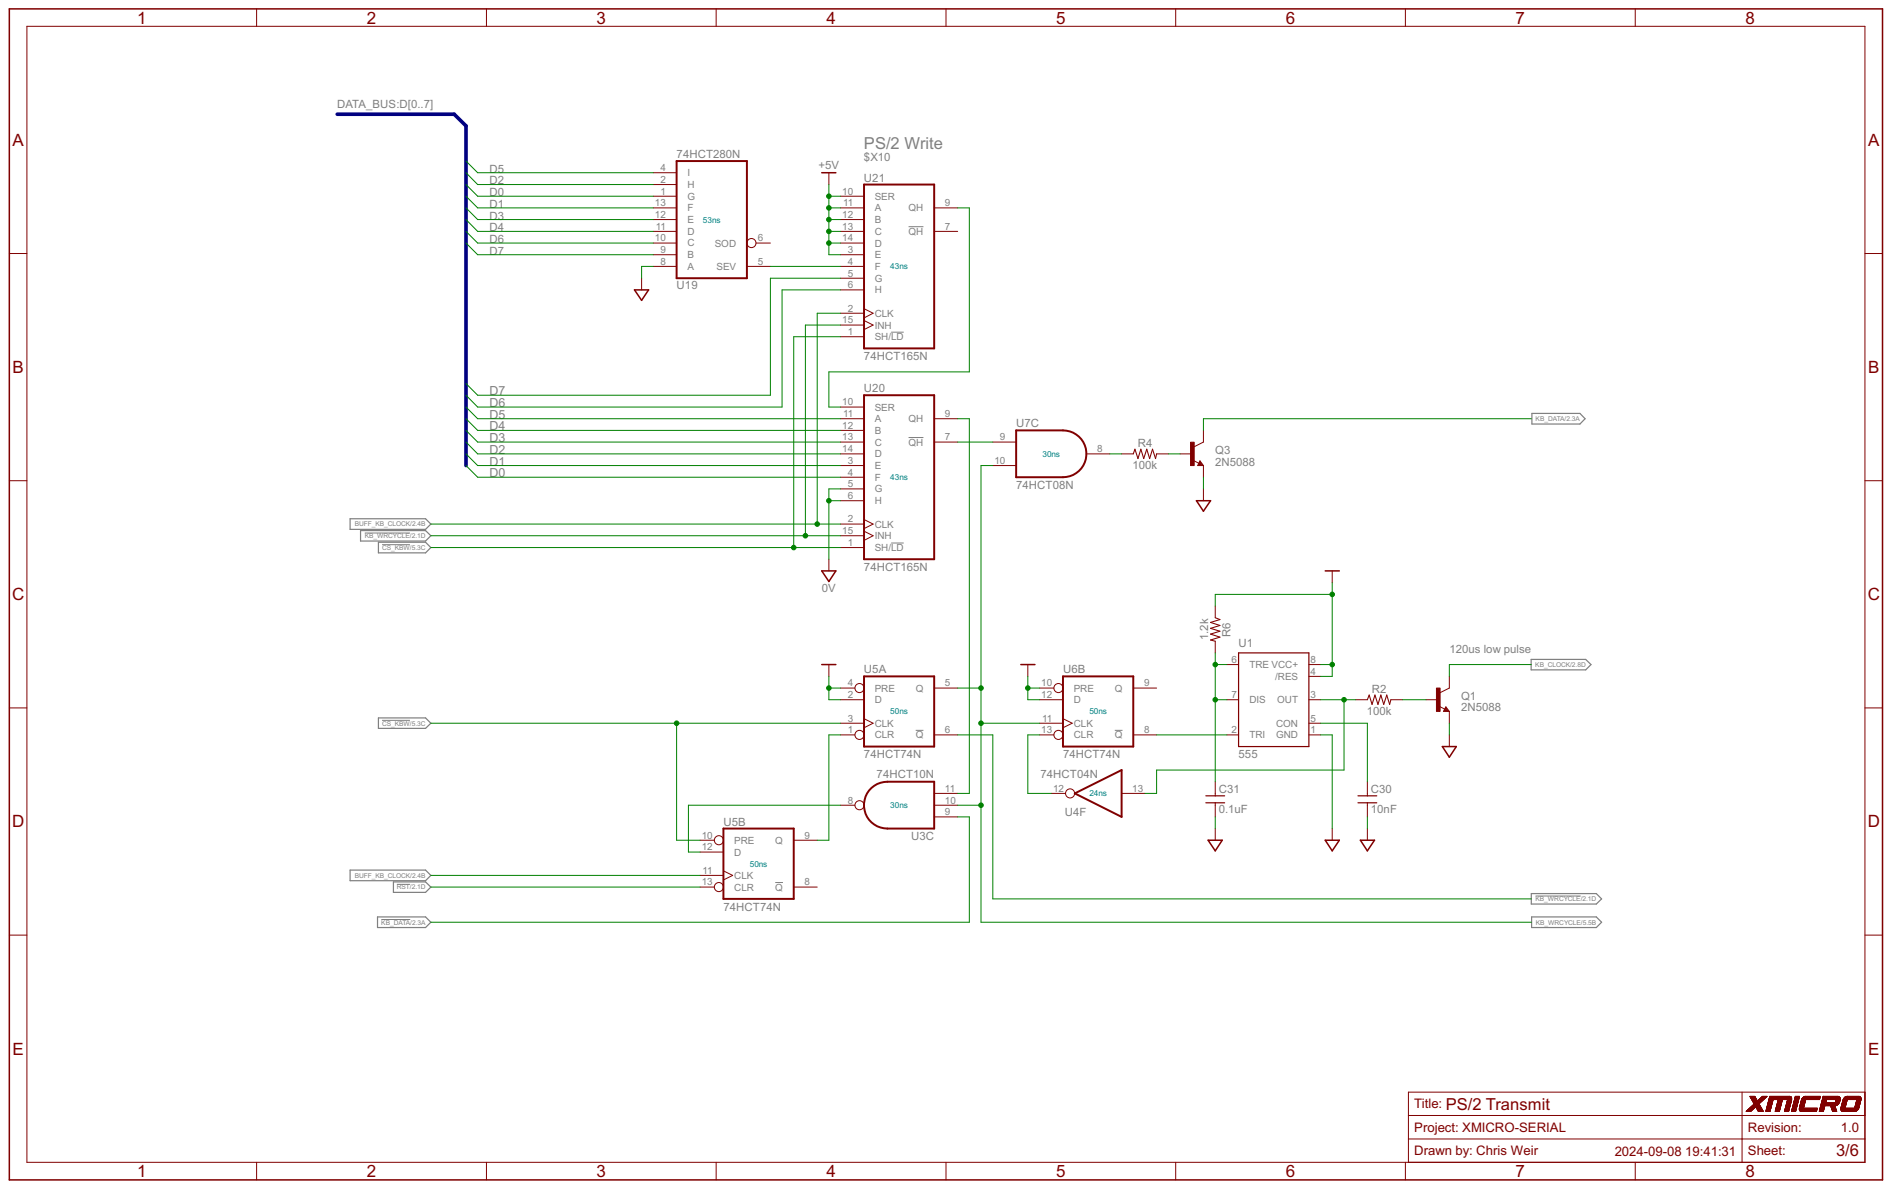
[picture p24: page 3]

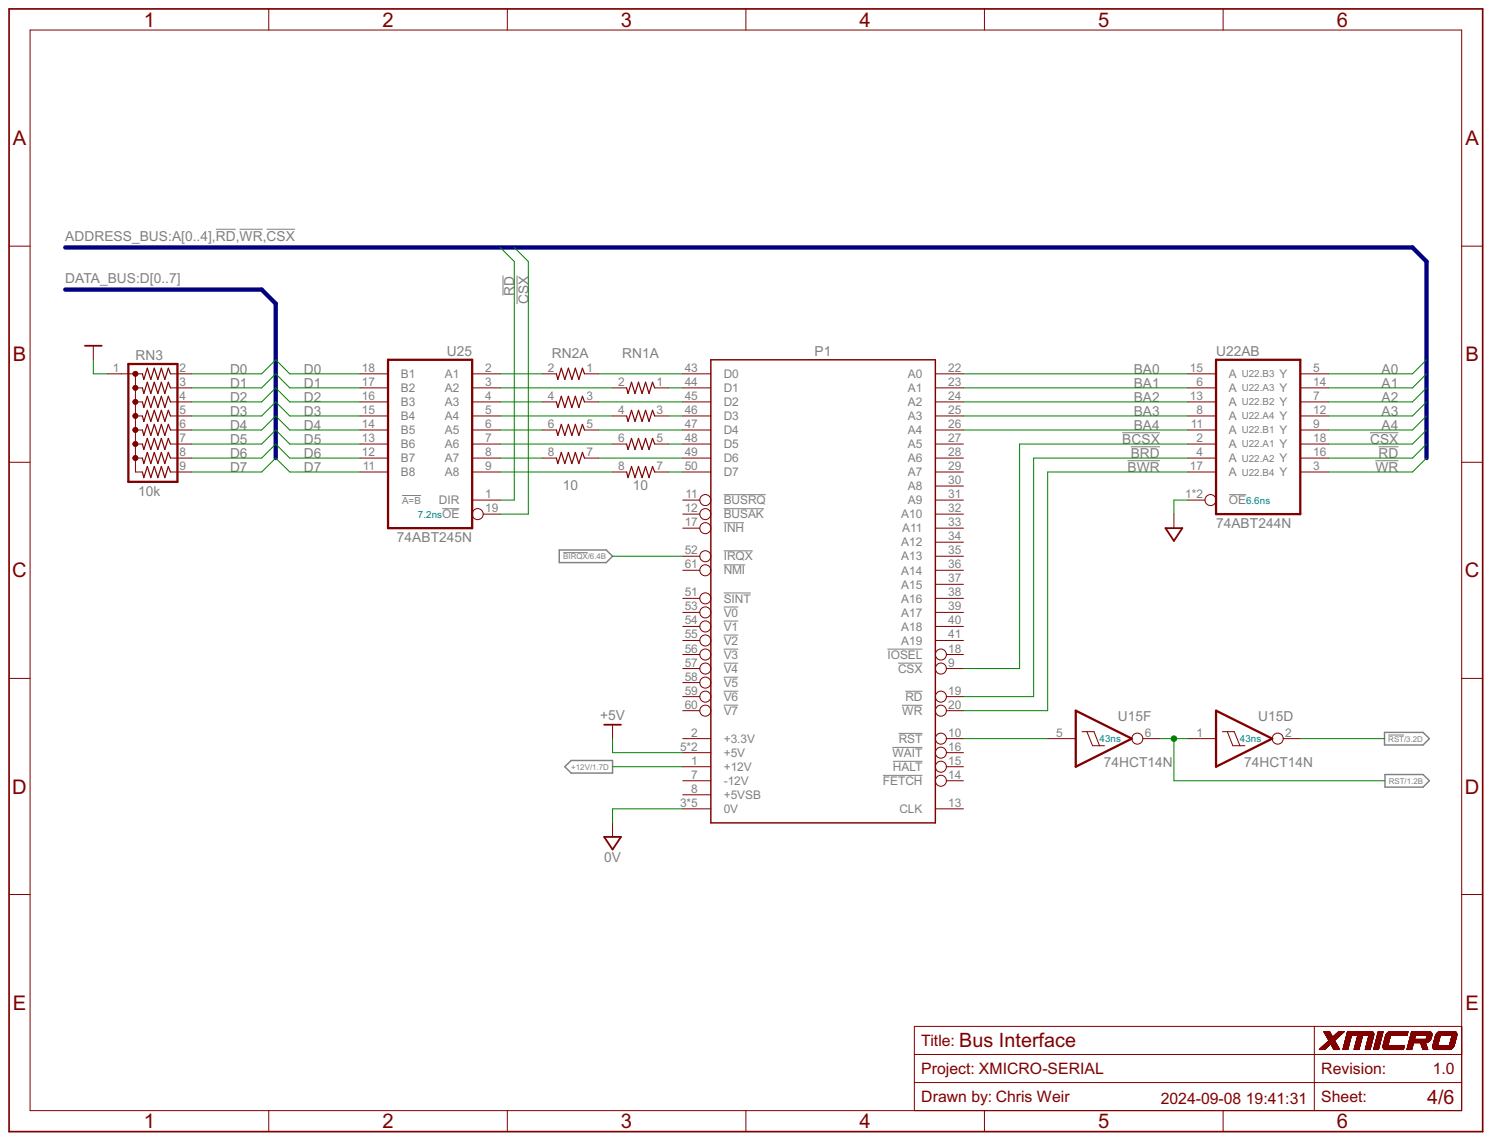
[picture p25: page 4]

Title: Project: Drawn by: Bus Interface XMICRO-SERIAL | Revision: Chris Weir Sheet: 4/6 1.0

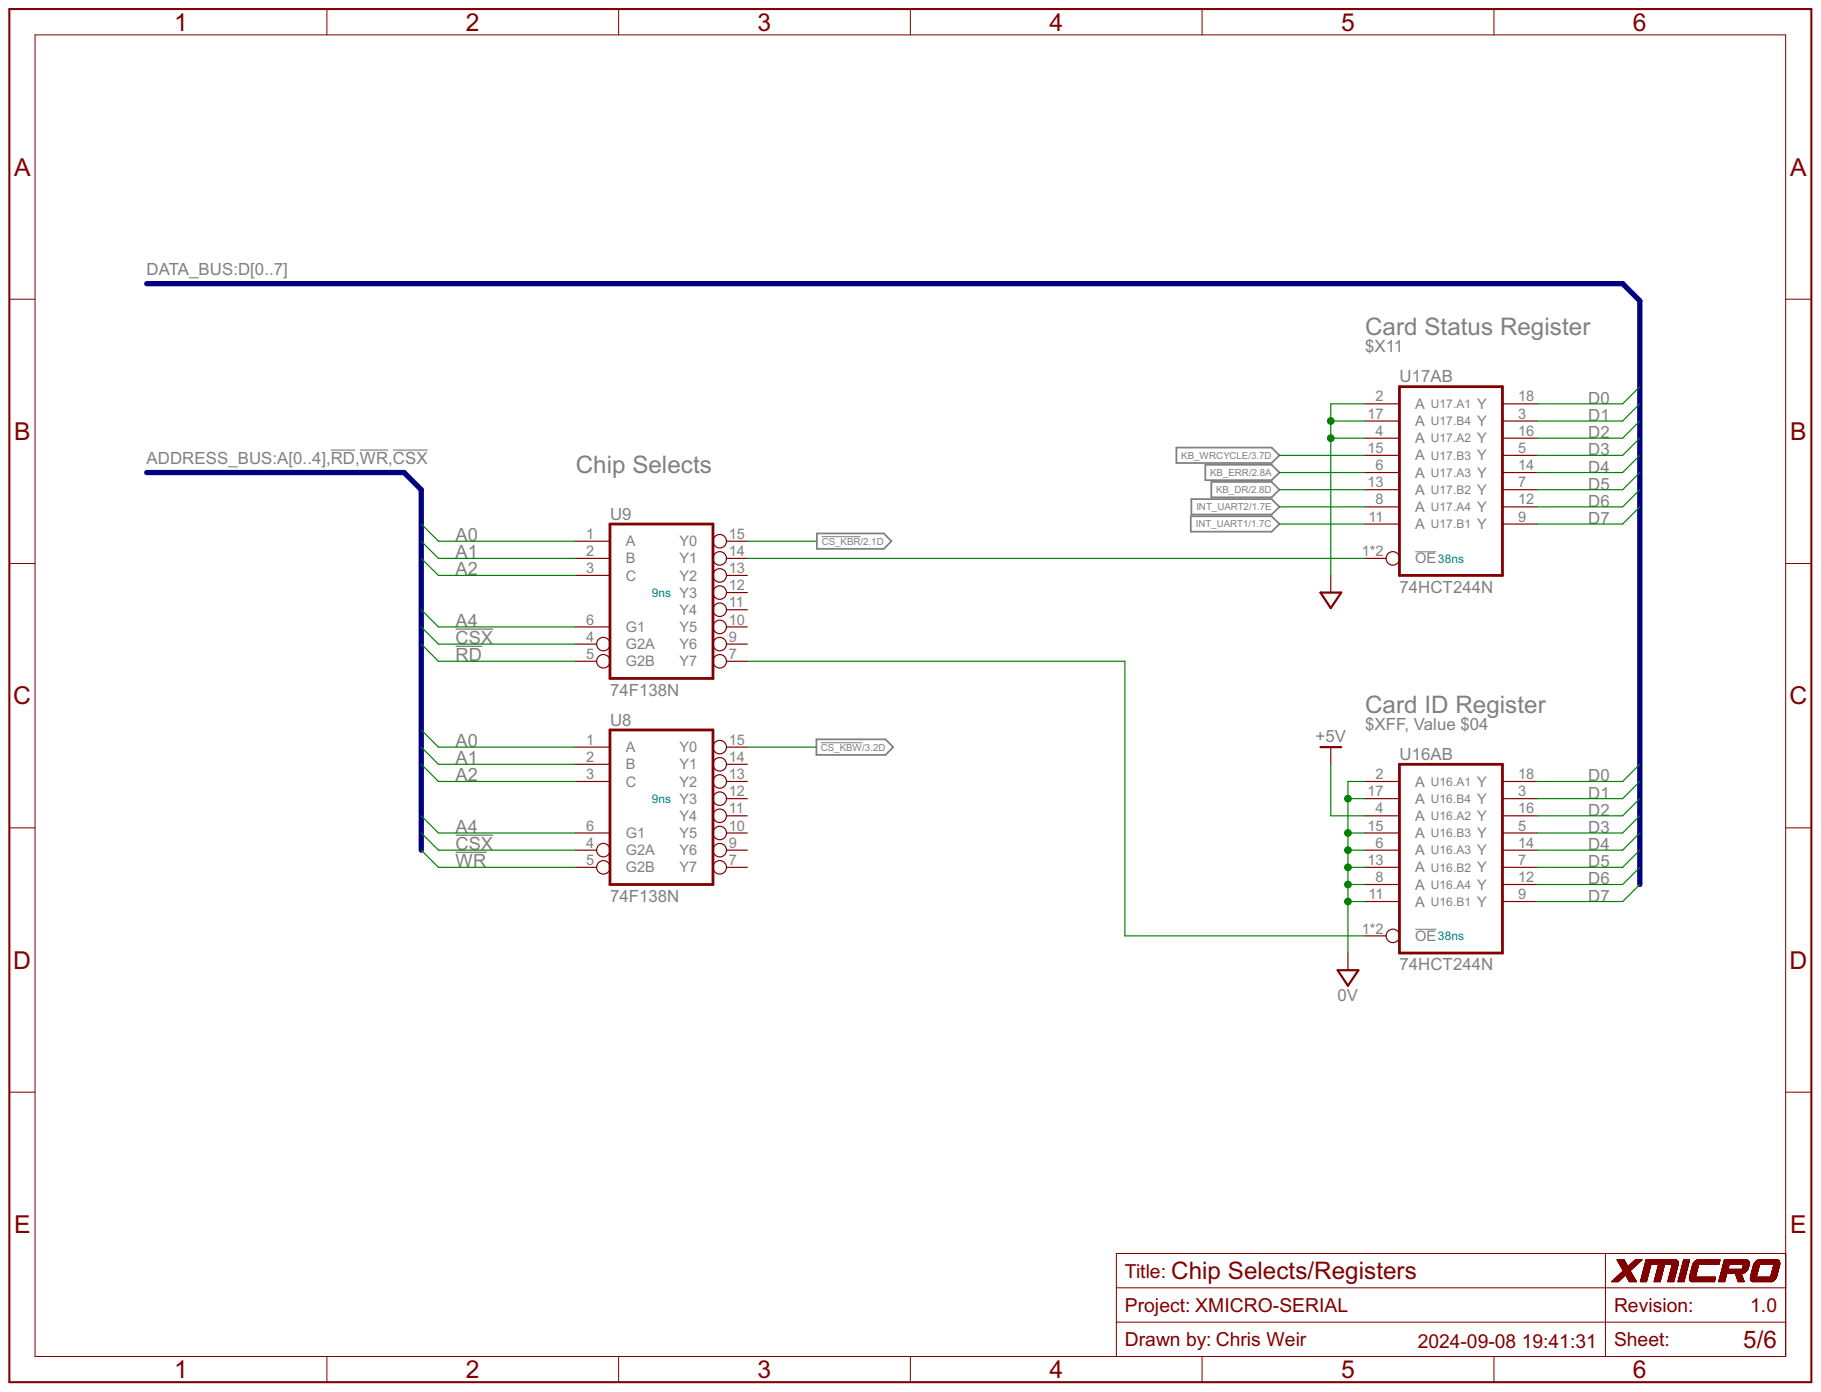
[picture p26: page 5]

Drawn by: Chip Selects/Registers

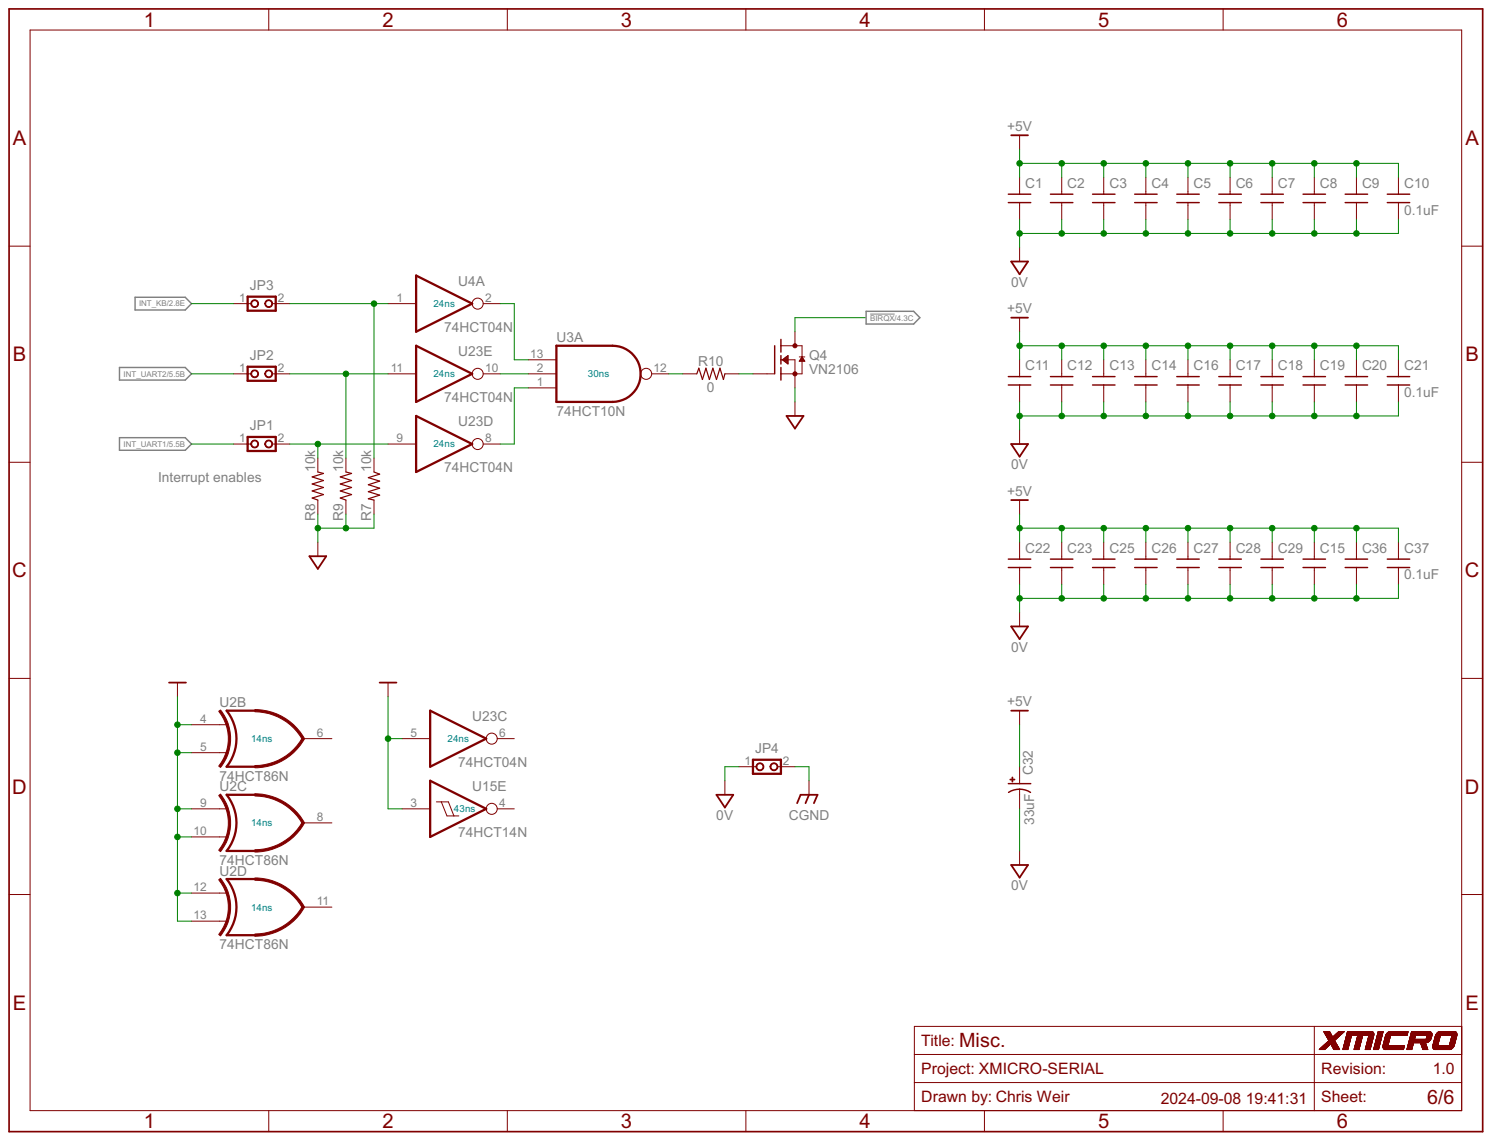
[picture p27: page 6]
