X-Microsystems/xmicro-serial/Documentation/Document Resources/4.pdf

Title: Project: Drawn by: Bus Interface XMICRO-SERIAL | Revision: Chris Weir Sheet: 4/6 1.0
