X-Microsystems/xmicro-serial/Documentation/Document Resources/5.pdf

Title: Project: Drawn by: Chip Selects/Registers XMICRO-SERIAL | Revision: Chris Weir Sheet: 5/6 1.0
