X-Microsystems/xmicro-serial/Documentation/Document Resources/6.pdf

Title: Project: Drawn by: Misc. XMICRO-SERIAL | Revision: Chris Weir Sheet: 6/6 1.0
