X-Microsystems/xmicro-serial/Hardware/CAD/XMICRO-SERIAL V1.0.brd

## EAGLE design Hardware/CAD/XMICRO-SERIAL V1.0.brd (2024-09-09, an earlier design)

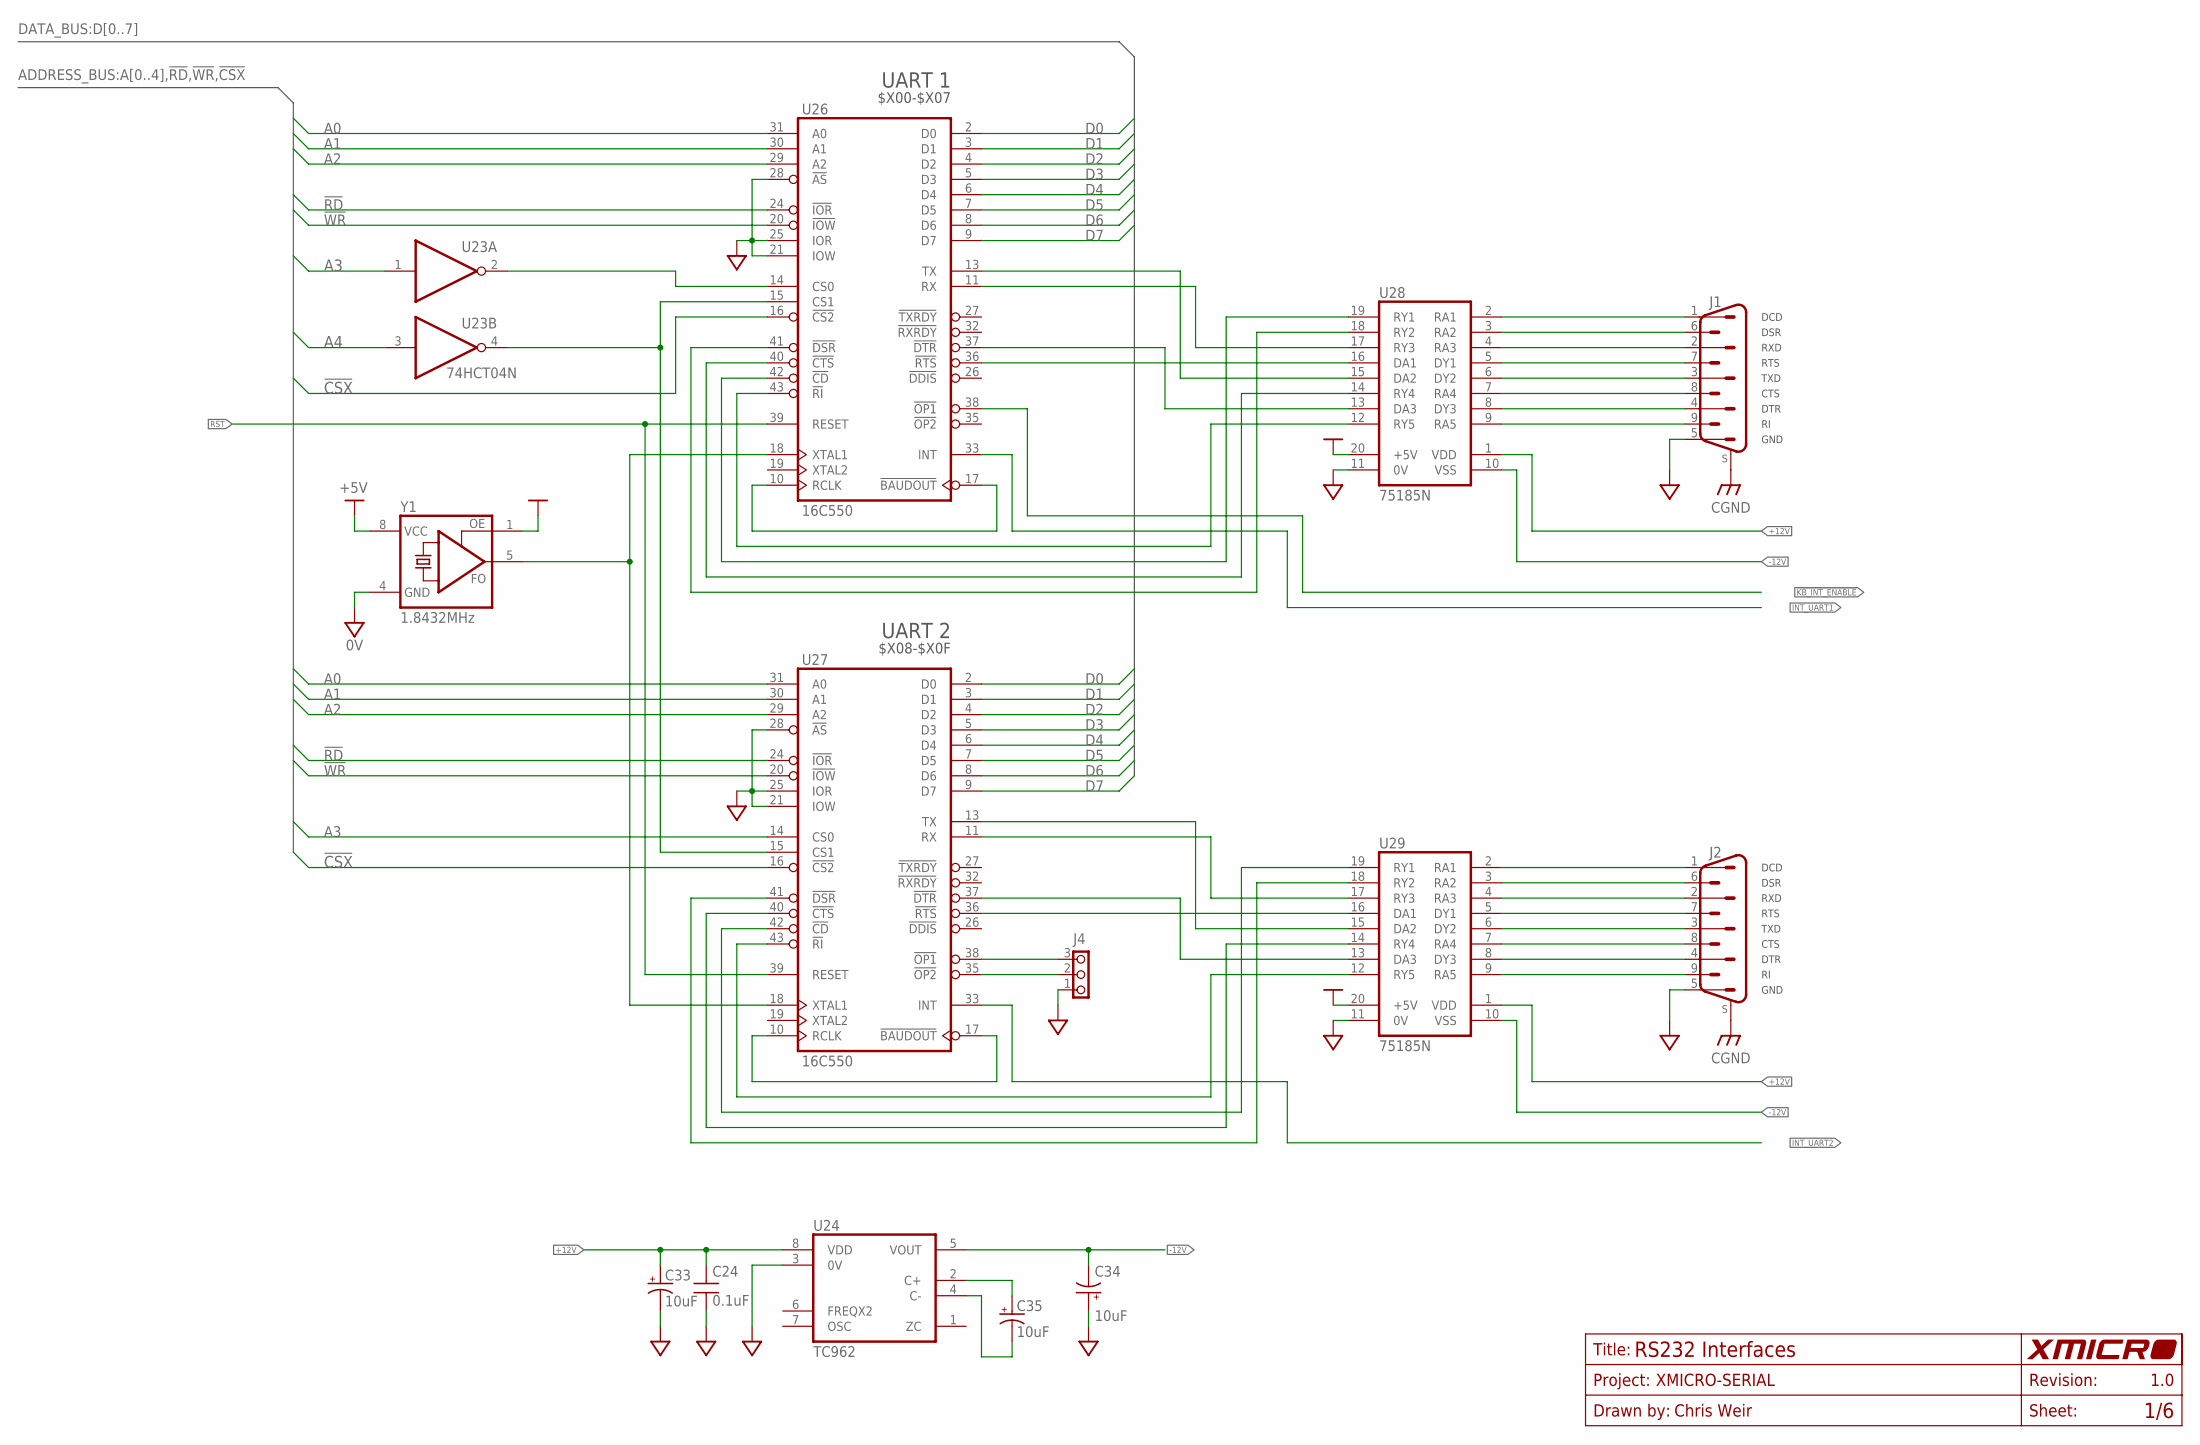
[picture p28: schematic XMICRO-SERIAL V1.0.sch, sheet 1, UARTs]

Parts:
C24: 0.1uF; C025-024X044
C33, C34, C35: 10uF; E2,5-5
J1, J2: DSUB-9M-PH; DSUB-9M-H
J4: 1X3
U23: 74HCT04N; DIL14
U24: TC962; DIL8
U26, U27: 16C550; S44
U28, U29: 75185N; DIL20
Y1: 1.8432MHz; DIL08S

Connections:
0V: C24.2, C33.-, C34.+, J1.5, J2.5, J4.1, U23.7 (0V), U24.3 (0V), U26.21 (IOW), U26.22 (0V), U26.25 (IOR), U26.28 (!AS), U27.21 (IOW), U27.22 (0V), U27.25 (IOR), U27.28 (!AS), U28.11 (0V), U29.11 (0V), Y1.4 (0V); also elsewhere on the board
!CSX: U26.16 (!CS2), U27.16 (!CS2); also elsewhere on the board
!KB_INT_ENABLE: U26.38 (!OP1); also elsewhere on the board
!RD: U26.24 (!IOR), U27.24 (!IOR); also elsewhere on the board
!WR: U26.20 (!IOW), U27.20 (!IOW); also elsewhere on the board
+5V: U23.14 (+5V), U26.44 (+5V), U27.44 (+5V), U28.20 (+5V), U29.20 (+5V), Y1.1 (OE), Y1.8 (+5V); also elsewhere on the board
+12V: C24.1, C33.+, U24.8 (VDD), U28.1 (VDD), U29.1 (VDD); also elsewhere on the board
-12V: C34.-, U24.5 (VOUT), U28.10 (VSS), U29.10 (VSS)
A0: U26.31 (A0), U27.31 (A0); also elsewhere on the board
A1: U26.30 (A1), U27.30 (A1); also elsewhere on the board
A2: U26.29 (A2), U27.29 (A2); also elsewhere on the board
A3: U23.1 (I), U27.14 (CS0); also elsewhere on the board
A4: U23.3 (I); also elsewhere on the board
CGND: J1.S1 (S), J1.S2 (S), J2.S1 (S), J2.S2 (S); also elsewhere on the board
D0: U26.2 (D0), U27.2 (D0); also elsewhere on the board
D1: U26.3 (D1), U27.3 (D1); also elsewhere on the board
D2: U26.4 (D2), U27.4 (D2); also elsewhere on the board
D3: U26.5 (D3), U27.5 (D3); also elsewhere on the board
D4: U26.6 (D4), U27.6 (D4); also elsewhere on the board
D5: U26.7 (D5), U27.7 (D5); also elsewhere on the board
D6: U26.8 (D6), U27.8 (D6); also elsewhere on the board
D7: U26.9 (D7), U27.9 (D7); also elsewhere on the board
INT_UART1: U26.33 (INT); also elsewhere on the board
INT_UART2: U27.33 (INT); also elsewhere on the board
unnamed: J1.1, U28.2 (RA1)
unnamed: J1.2, U28.4 (RA3)
unnamed: J1.3, U28.6 (DY2)
unnamed: J1.4, U28.8 (DY3)
unnamed: J1.6, U28.3 (RA2)
unnamed: J1.7, U28.5 (DY1)
unnamed: J1.8, U28.7 (RA4)
unnamed: J1.9, U28.9 (RA5)
unnamed: J2.1, U29.2 (RA1)
unnamed: U26.43 (!RI), U28.12 (RY5)
unnamed: U26.37 (!DTR), U28.13 (DA3)
unnamed: U26.40 (!CTS), U28.14 (RY4)
unnamed: U26.13 (TX), U28.15 (DA2)
unnamed: U26.36 (!RTS), U28.16 (DA1)
unnamed: U26.11 (RX), U28.17 (RY3)
unnamed: U26.41 (!DSR), U28.18 (RY2)
unnamed: U26.42 (!CD), U28.19 (RY1)
unnamed: U26.10 (RCLK), U26.17 (!BAUDOUT)
unnamed: C35.-, U24.4 (C-)
unnamed: J2.2, U29.4 (RA3)
unnamed: J2.3, U29.6 (DY2)
unnamed: J2.4, U29.8 (DY3)
unnamed: J2.6, U29.3 (RA2)
unnamed: J2.7, U29.5 (DY1)
unnamed: J2.8, U29.7 (RA4)
unnamed: J2.9, U29.9 (RA5)
unnamed: C35.+, U24.2 (C+)
unnamed: U23.2 (O), U26.14 (CS0)
unnamed: U27.43 (!RI), U29.12 (RY5)
unnamed: U27.37 (!DTR), U29.13 (DA3)
unnamed: U27.40 (!CTS), U29.14 (RY4)
unnamed: J4.3, U27.38 (!OP1)
unnamed: J4.2, U27.35 (!OP2)
unnamed: U27.13 (TX), U29.15 (DA2)
unnamed: U27.36 (!RTS), U29.16 (DA1)
unnamed: U27.11 (RX), U29.17 (RY3)
unnamed: U27.41 (!DSR), U29.18 (RY2)
unnamed: U27.42 (!CD), U29.19 (RY1)
unnamed: U27.10 (RCLK), U27.17 (!BAUDOUT)
unnamed: U23.4 (O), U26.15 (CS1), U27.15 (CS1)
unnamed: U26.18 (XTAL1), U27.18 (XTAL1), Y1.5 (FO)
RST: U26.39 (RESET), U27.39 (RESET); also elsewhere on the board

Notes on the sheet:
DTR
CTS
TXD
RTS
RXD
DSR
DCD
GND
UART 1
$X00-$X07
UART 2
$X08-$X0F

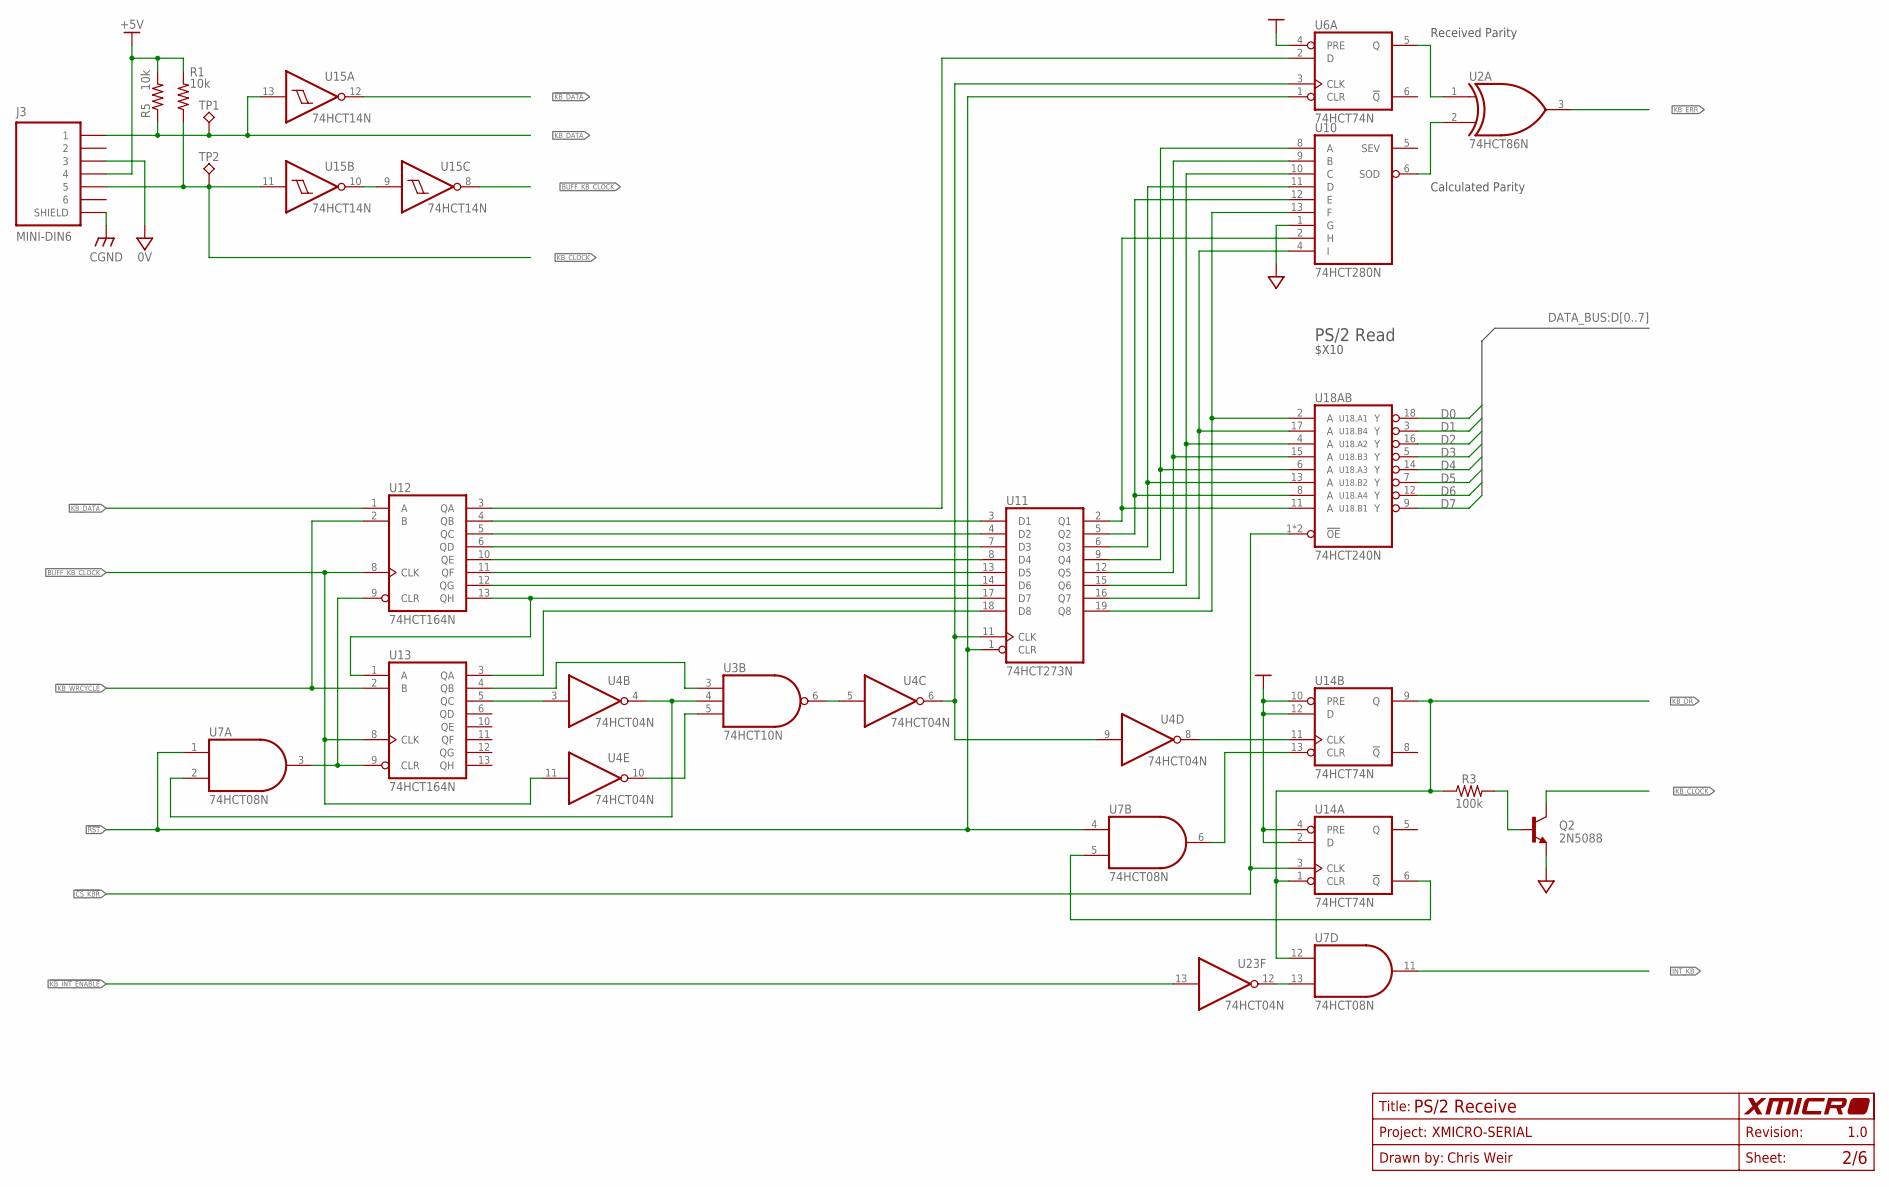
[picture p29: schematic XMICRO-SERIAL V1.0.sch, sheet 2, PS/2 Receive]

Parts:
J3: MINI-DIN6
Q2: 2N5088; TO92
R1, R5: 10k; 0207/10
R3: 100k; 0207/10
TP1, TP2: TP-040
U2: 74HCT86N; DIL14
U3: 74HCT10N; DIL14
U4, U23: 74HCT04N; DIL14
U6, U14: 74HCT74N; DIL14
U7: 74HCT08N; DIL14
U10: 74HCT280N; DIL14
U11: 74HCT273N; DIL20
U12, U13: 74HCT164N; DIL14
U15: 74HCT14N; DIL14
U18: 74HCT240N; DIL20

Connections:
0V: J3.3, Q2.1 (E), U2.7 (0V), U3.7 (0V), U4.7 (0V), U6.7 (0V), U7.7 (0V), U10.1 (G), U10.7 (0V), U11.10 (0V), U12.7 (0V), U13.7 (0V), U14.7 (0V), U15.7 (0V), U18.10 (0V), U23.7 (0V); also elsewhere on the board
!CS_KBR: U14.3 (CLK), U18.1 (!OE), U18.19 (!OE); also elsewhere on the board
!KB_DATA: U12.1 (A), U15.12 (O); also elsewhere on the board
!KB_INT_ENABLE: U23.13 (I); also elsewhere on the board
!KB_WRCYCLE: U12.2 (B), U13.2 (B); also elsewhere on the board
!RST: U6.1 (CLR), U7.1 (I0), U7.4 (I0), U11.1 (CLR); also elsewhere on the board
+5V: J3.4, R1.2, R5.2, U2.14 (+5V), U3.14 (+5V), U4.14 (+5V), U6.4 (PRE), U6.14 (+5V), U7.14 (+5V), U10.14 (+5V), U11.20 (+5V), U12.14 (+5V), U13.14 (+5V), U14.2 (D), U14.4 (PRE), U14.10 (PRE), U14.12 (D), U14.14 (+5V), U15.14 (+5V), U18.20 (+5V), U23.14 (+5V); also elsewhere on the board
BUFF_KB_CLOCK: U4.11 (I), U12.8 (CLK), U13.8 (CLK), U15.8 (O); also elsewhere on the board
CGND: J3.G$1 (SHIELD), J3.G$2 (SHIELD), J3.G$3 (SHIELD); also elsewhere on the board
D0: U18.18 (Y); also elsewhere on the board
D1: U18.3 (Y); also elsewhere on the board
D2: U18.16 (Y); also elsewhere on the board
D3: U18.5 (Y); also elsewhere on the board
D4: U18.14 (Y); also elsewhere on the board
D5: U18.7 (Y); also elsewhere on the board
D6: U18.12 (Y); also elsewhere on the board
D7: U18.9 (Y); also elsewhere on the board
INT_KB: U7.11 (O); also elsewhere on the board
KB_CLOCK: J3.5, Q2.3 (C), R1.1, TP2.1, U15.11 (I); also elsewhere on the board
KB_DATA: J3.1, R5.1, TP1.1, U15.13 (I); also elsewhere on the board
KB_DR: R3.1, U7.12 (I0), U14.1 (CLR), U14.9 (Q); also elsewhere on the board
KB_ERR: U2.3 (O); also elsewhere on the board
unnamed: U3.6 (O), U4.5 (I)
unnamed: U4.8 (O), U14.11 (CLK)
unnamed: U15.9 (I), U15.10 (O)
unnamed: U7.13 (I1), U23.12 (O)
unnamed: U11.17 (D7), U12.13 (QH), U13.1 (A)
unnamed: U11.18 (D8), U13.3 (QA)
unnamed: U4.3 (I), U13.5 (QC)
unnamed: U3.4 (I1), U4.4 (O), U7.2 (I1)
unnamed: U4.6 (O), U4.9 (I), U6.3 (CLK), U11.11 (CLK)
unnamed: U3.3 (I0), U13.4 (QB)
unnamed: U11.14 (D6), U12.12 (QG)
unnamed: U11.13 (D5), U12.11 (QF)
unnamed: U11.7 (D3), U12.6 (QD)
unnamed: U11.4 (D2), U12.5 (QC)
unnamed: U11.3 (D1), U12.4 (QB)
unnamed: U6.2 (D), U12.3 (QA)
unnamed: U7.3 (O), U12.9 (CLR), U13.9 (CLR)
unnamed: U7.6 (O), U14.13 (CLR)
unnamed: U2.1 (I0), U6.5 (Q)
unnamed: U10.13 (F), U11.19 (Q8), U18.2 (A)
unnamed: U10.4 (I), U11.16 (Q7), U18.17 (A)
unnamed: U10.10 (C), U11.15 (Q6), U18.4 (A)
unnamed: U10.9 (B), U11.12 (Q5), U18.15 (A)
unnamed: U10.11 (D), U11.6 (Q3), U18.13 (A)
unnamed: U10.12 (E), U11.5 (Q2), U18.8 (A)
unnamed: U10.2 (H), U11.2 (Q1), U18.11 (A)
unnamed: U10.8 (A), U11.9 (Q4), U18.6 (A)
unnamed: U2.2 (I1), U10.6 (SOD)
unnamed: U3.5 (I2), U4.10 (O)
unnamed: Q2.2 (B), R3.2
unnamed: U7.5 (I1), U14.6 (!Q)
UC4: U11.8 (D4), U12.10 (QE)

Notes on the sheet:
Received Parity
Calculated Parity
PS/2 Read
$X10

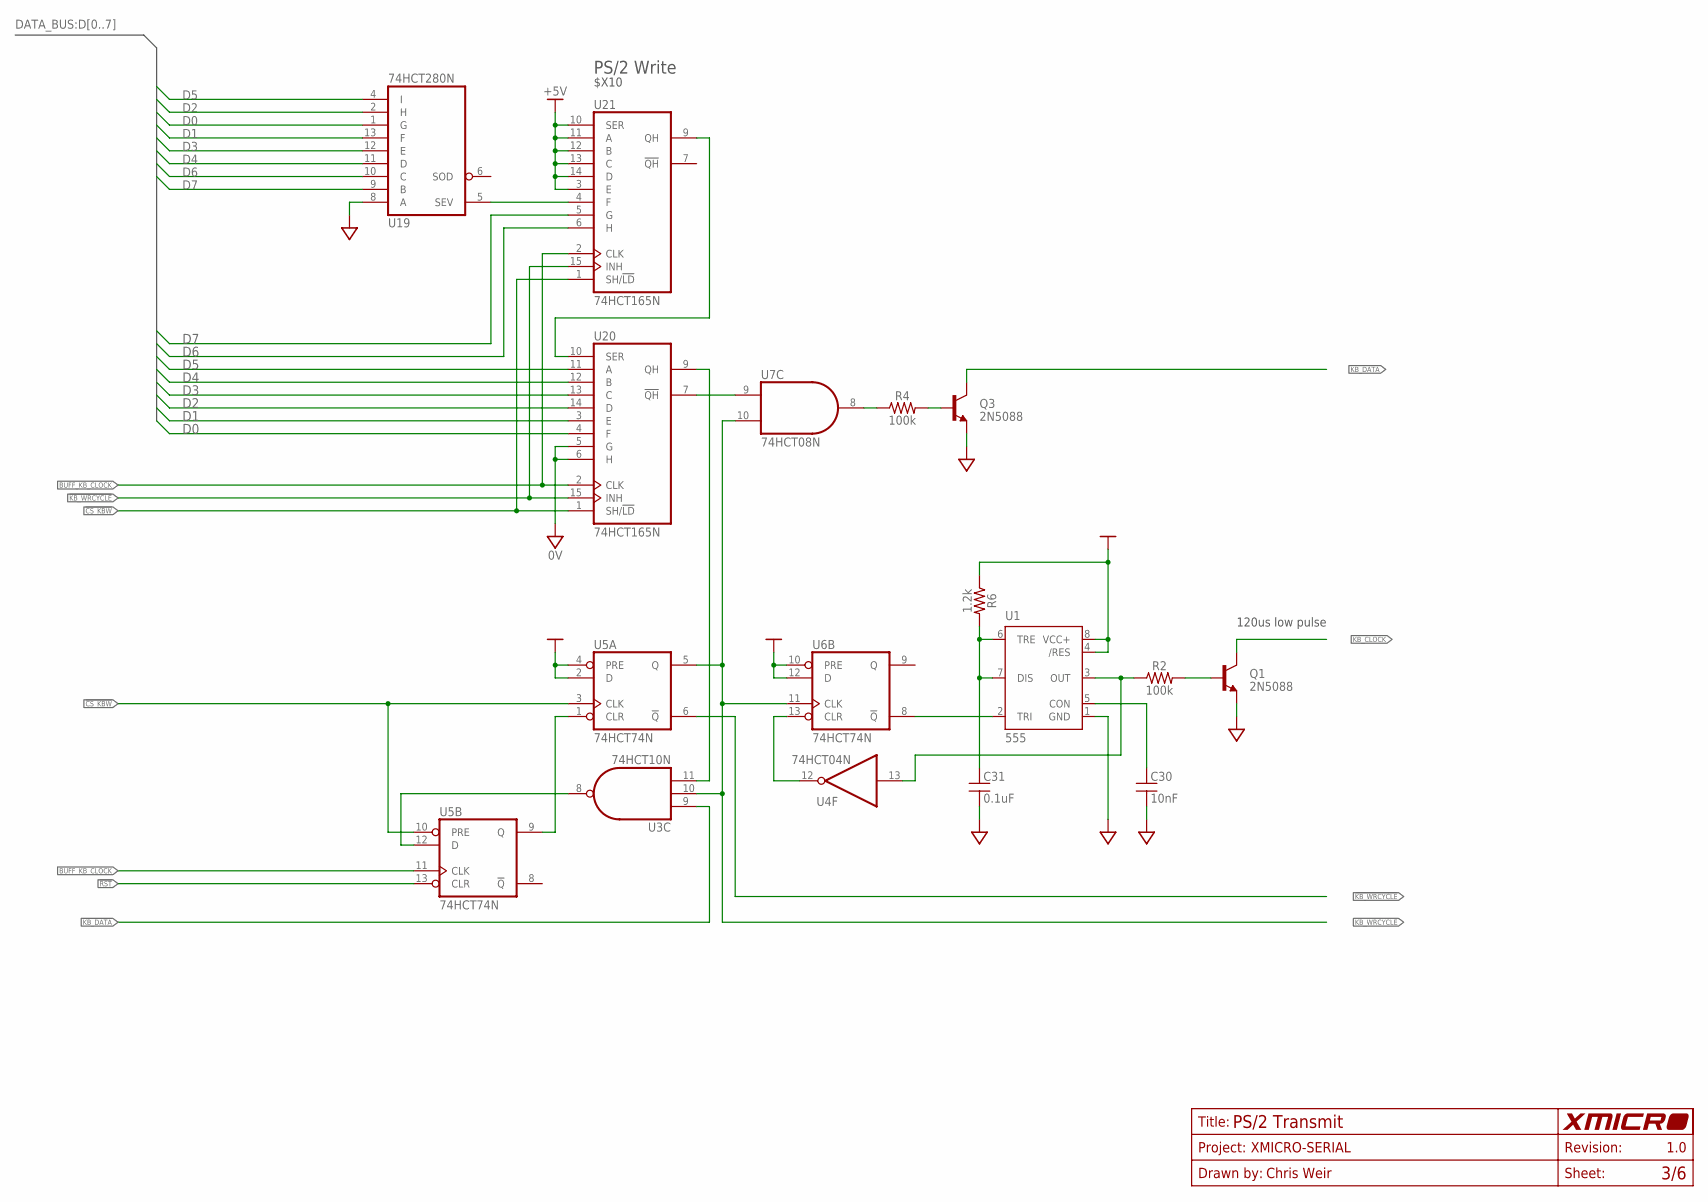
[picture p30: schematic XMICRO-SERIAL V1.0.sch, sheet 3, PS/2 Transmit]

Parts:
C30: 10nF; C025-024X044
C31: 0.1uF; C025-024X044
Q1, Q3: 2N5088; TO92
R2, R4: 100k; 0207/10
R6: 1.2k; 0207/10
U1: 555; DIL-08
U3: 74HCT10N; DIL14
U4: 74HCT04N; DIL14
U5, U6: 74HCT74N; DIL14
U7: 74HCT08N; DIL14
U19: 74HCT280N; DIL14
U20, U21: 74HCT165N; DIL16

Connections:
0V: C30.2, C31.2, Q1.1 (E), Q3.1 (E), U1.1 (GND), U3.7 (0V), U4.7 (0V), U5.7 (0V), U6.7 (0V), U7.7 (0V), U19.7 (0V), U19.8 (A), U20.5 (G), U20.6 (H), U20.8 (0V), U21.8 (0V); also elsewhere on the board
!CS_KBW: U5.3 (CLK), U5.10 (PRE), U20.1 (SH/!LD), U21.1 (SH/!LD); also elsewhere on the board
!KB_DATA: U3.9 (I0); also elsewhere on the board
!KB_WRCYCLE: U5.6 (!Q), U20.15 (INH), U21.15 (INH); also elsewhere on the board
!RST: U5.13 (CLR); also elsewhere on the board
+5V: R6.1, U1.4 (/RES), U1.8 (VCC+), U3.14 (+5V), U4.14 (+5V), U5.2 (D), U5.4 (PRE), U5.14 (+5V), U6.10 (PRE), U6.12 (D), U6.14 (+5V), U7.14 (+5V), U19.14 (+5V), U20.16 (+5V), U21.3 (E), U21.10 (SER), U21.11 (A), U21.12 (B), U21.13 (C), U21.14 (D), U21.16 (+5V); also elsewhere on the board
BUFF_KB_CLOCK: U5.11 (CLK), U20.2 (CLK), U21.2 (CLK); also elsewhere on the board
D0: U19.1 (G), U20.4 (F); also elsewhere on the board
D1: U19.13 (F), U20.3 (E); also elsewhere on the board
D2: U19.2 (H), U20.14 (D); also elsewhere on the board
D3: U19.12 (E), U20.13 (C); also elsewhere on the board
D4: U19.11 (D), U20.12 (B); also elsewhere on the board
D5: U19.4 (I), U20.11 (A); also elsewhere on the board
D6: U19.10 (C), U21.6 (H); also elsewhere on the board
D7: U19.9 (B), U21.5 (G); also elsewhere on the board
KB_CLOCK: Q1.3 (C); also elsewhere on the board
KB_DATA: Q3.3 (C); also elsewhere on the board
KB_WRCYCLE: U3.10 (I1), U5.5 (Q), U6.11 (CLK), U7.10 (I1); also elsewhere on the board
unnamed: U3.8 (O), U5.12 (D)
unnamed: U4.12 (O), U6.13 (CLR)
unnamed: U3.11 (I2), U20.9 (QH)
unnamed: U7.9 (I0), U20.7 (!QH)
unnamed: R4.1, U7.8 (O)
unnamed: U20.10 (SER), U21.9 (QH)
unnamed: U19.5 (SEV), U21.4 (F)
unnamed: Q3.2 (B), R4.2
unnamed: Q1.2 (B), R2.2
unnamed: U5.1 (CLR), U5.9 (Q)
unnamed: U1.2 (TRI), U6.8 (!Q)
unnamed: C31.1, R6.2, U1.6 (TRE), U1.7 (DIS)
unnamed: R2.1, U1.3 (OUT), U4.13 (I)
unnamed: C30.1, U1.5 (CON)

Notes on the sheet:
120us low pulse
PS/2 Write
$X10

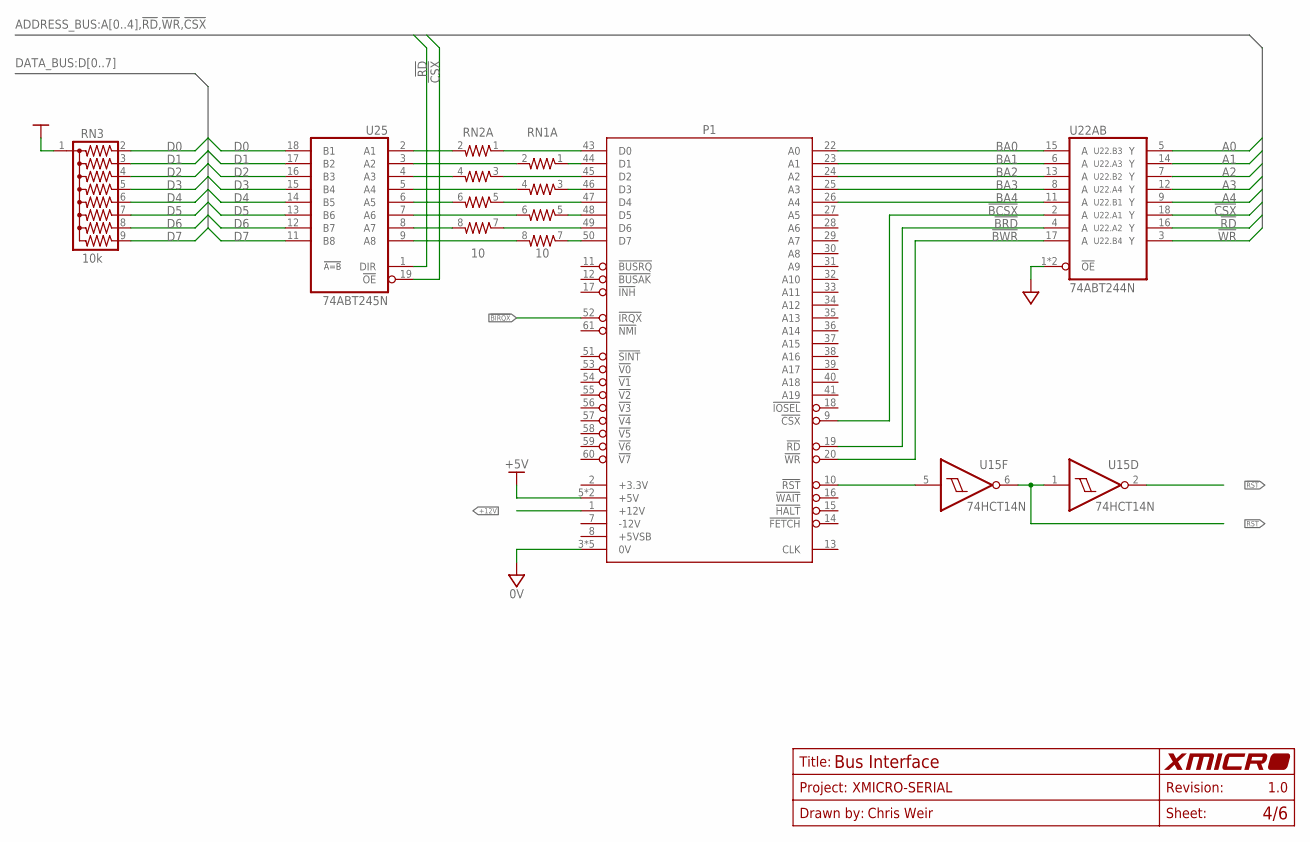
[picture p31: schematic XMICRO-SERIAL V1.0.sch, sheet 4, Bus Interface]

Parts:
P1: XMICRO-BUS-EDGE; EDGE62M
RN1, RN2: 10; SIL8
RN3: 10k; SIL9
U15: 74HCT14N; DIL14
U22: 74ABT244N; DIL20
U25: 74ABT245N; DIL20

Connections:
0V: P1.3 (0V), P1.4 (0V), P1.21 (0V), P1.42 (0V), P1.62 (0V), U15.7 (0V), U22.1 (!OE), U22.10 (0V), U22.19 (!OE), U25.10 (0V); also elsewhere on the board
!BCSX: P1.9 (!CSX), U22.2 (A)
!BIRQX: P1.52 (!IRQX); also elsewhere on the board
!BRD: P1.19 (!RD), U22.4 (A)
!BRST: P1.10 (!RST), U15.5 (I)
!BWR: P1.20 (!WR), U22.17 (A)
!CSX: U22.18 (Y), U25.19 (!OE); also elsewhere on the board
!RD: U22.16 (Y), U25.1 (DIR); also elsewhere on the board
!RST: U15.2 (O); also elsewhere on the board
!WR: U22.3 (Y); also elsewhere on the board
+5V: P1.5 (+5V), P1.6 (+5V), RN3.1, U15.14 (+5V), U22.20 (+5V), U25.20 (+5V); also elsewhere on the board
+12V: P1.1 (+12V); also elsewhere on the board
A0: U22.5 (Y); also elsewhere on the board
A1: U22.14 (Y); also elsewhere on the board
A2: U22.7 (Y); also elsewhere on the board
A3: U22.12 (Y); also elsewhere on the board
A4: U22.9 (Y); also elsewhere on the board
BA0: P1.22 (A0), U22.15 (A)
BA1: P1.23 (A1), U22.6 (A)
BA2: P1.24 (A2), U22.13 (A)
BA3: P1.25 (A3), U22.8 (A)
BA4: P1.26 (A4), U22.11 (A)
D0: RN3.2, U25.18 (B1); also elsewhere on the board
D1: RN3.3, U25.17 (B2); also elsewhere on the board
D2: RN3.4, U25.16 (B3); also elsewhere on the board
D3: RN3.5, U25.15 (B4); also elsewhere on the board
D4: RN3.6, U25.14 (B5); also elsewhere on the board
D5: RN3.7, U25.13 (B6); also elsewhere on the board
D6: RN3.8, U25.12 (B7); also elsewhere on the board
D7: RN3.9, U25.11 (B8); also elsewhere on the board
unnamed: RN1.8 (2), U25.9 (A8)
unnamed: P1.49 (D6), RN2.7 (1)
unnamed: RN1.6 (2), U25.7 (A6)
unnamed: P1.47 (D4), RN2.5 (1)
unnamed: RN1.4 (2), U25.5 (A4)
unnamed: P1.45 (D2), RN2.3 (1)
unnamed: RN1.2, U25.3 (A2)
unnamed: P1.43 (D0), RN2.1
unnamed: RN2.2, U25.2 (A1)
unnamed: RN2.4 (2), U25.4 (A3)
unnamed: RN2.6 (2), U25.6 (A5)
unnamed: RN2.8 (2), U25.8 (A7)
unnamed: P1.50 (D7), RN1.7 (1)
unnamed: P1.48 (D5), RN1.5 (1)
unnamed: P1.46 (D3), RN1.3 (1)
unnamed: P1.44 (D1), RN1.1
RST: U15.1 (I), U15.6 (O); also elsewhere on the board

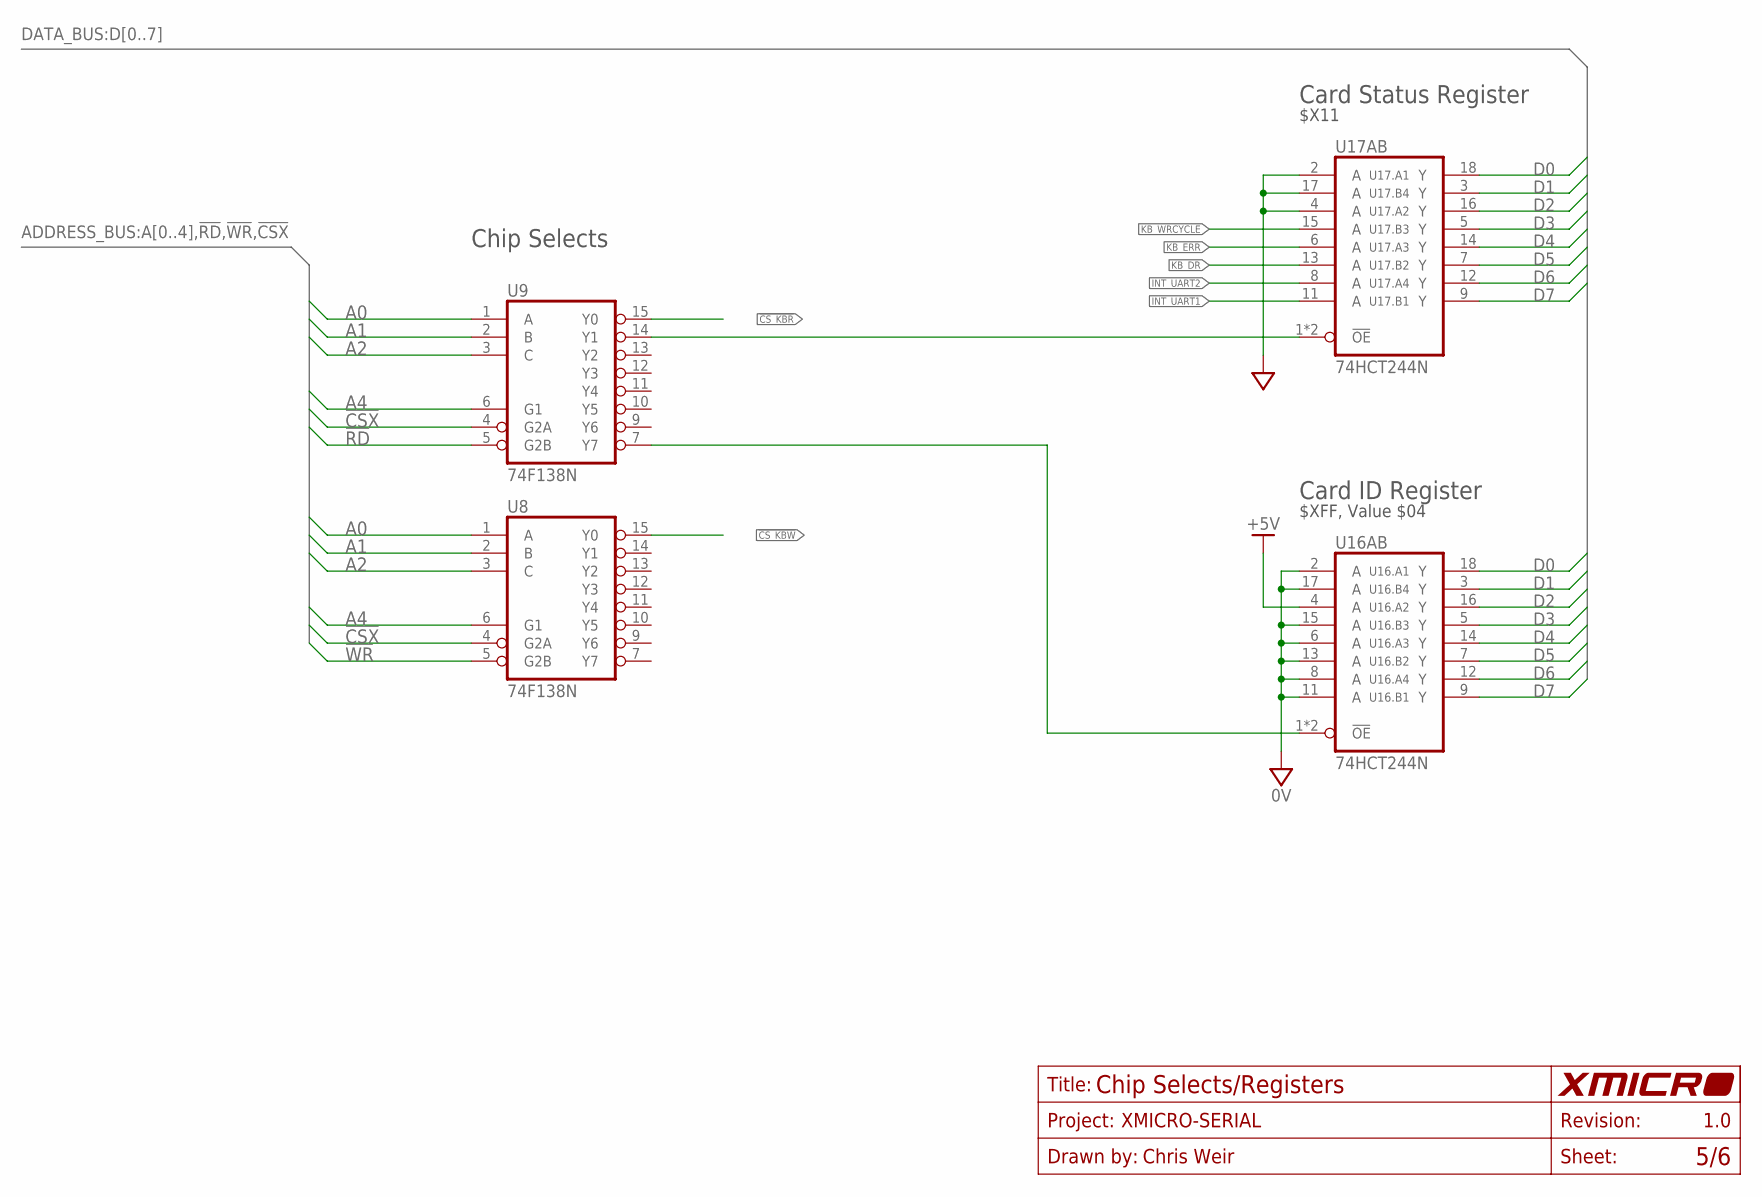
[picture p32: schematic XMICRO-SERIAL V1.0.sch, sheet 5, Chip Selects/Registers]

Parts:
U8, U9: 74F138N; DIL16
U16, U17: 74HCT244N; DIL20

Connections:
0V: U8.8 (0V), U9.8 (0V), U16.2 (A), U16.6 (A), U16.8 (A), U16.10 (0V), U16.11 (A), U16.13 (A), U16.15 (A), U16.17 (A), U17.2 (A), U17.4 (A), U17.10 (0V), U17.17 (A); also elsewhere on the board
!CSX: U8.4 (G2A), U9.4 (G2A); also elsewhere on the board
!CS_IDR: U9.7 (Y7), U16.1 (!OE), U16.19 (!OE)
!CS_KBR: U9.15 (Y0); also elsewhere on the board
!CS_KBW: U8.15 (Y0); also elsewhere on the board
!CS_STR: U9.14 (Y1), U17.1 (!OE), U17.19 (!OE)
!RD: U9.5 (G2B); also elsewhere on the board
!WR: U8.5 (G2B); also elsewhere on the board
+5V: U8.16 (+5V), U9.16 (+5V), U16.4 (A), U16.20 (+5V), U17.20 (+5V); also elsewhere on the board
A0: U8.1 (A), U9.1 (A); also elsewhere on the board
A1: U8.2 (B), U9.2 (B); also elsewhere on the board
A2: U8.3 (C), U9.3 (C); also elsewhere on the board
A4: U8.6 (G1), U9.6 (G1); also elsewhere on the board
D0: U16.18 (Y), U17.18 (Y); also elsewhere on the board
D1: U16.3 (Y), U17.3 (Y); also elsewhere on the board
D2: U16.16 (Y), U17.16 (Y); also elsewhere on the board
D3: U16.5 (Y), U17.5 (Y); also elsewhere on the board
D4: U16.14 (Y), U17.14 (Y); also elsewhere on the board
D5: U16.7 (Y), U17.7 (Y); also elsewhere on the board
D6: U16.12 (Y), U17.12 (Y); also elsewhere on the board
D7: U16.9 (Y), U17.9 (Y); also elsewhere on the board
INT_UART1: U17.11 (A); also elsewhere on the board
INT_UART2: U17.8 (A); also elsewhere on the board
KB_DR: U17.13 (A); also elsewhere on the board
KB_ERR: U17.6 (A); also elsewhere on the board
KB_WRCYCLE: U17.15 (A); also elsewhere on the board

Notes on the sheet:
Card ID Register
$XFF, Value $04
Chip Selects
Card Status Register
$X11

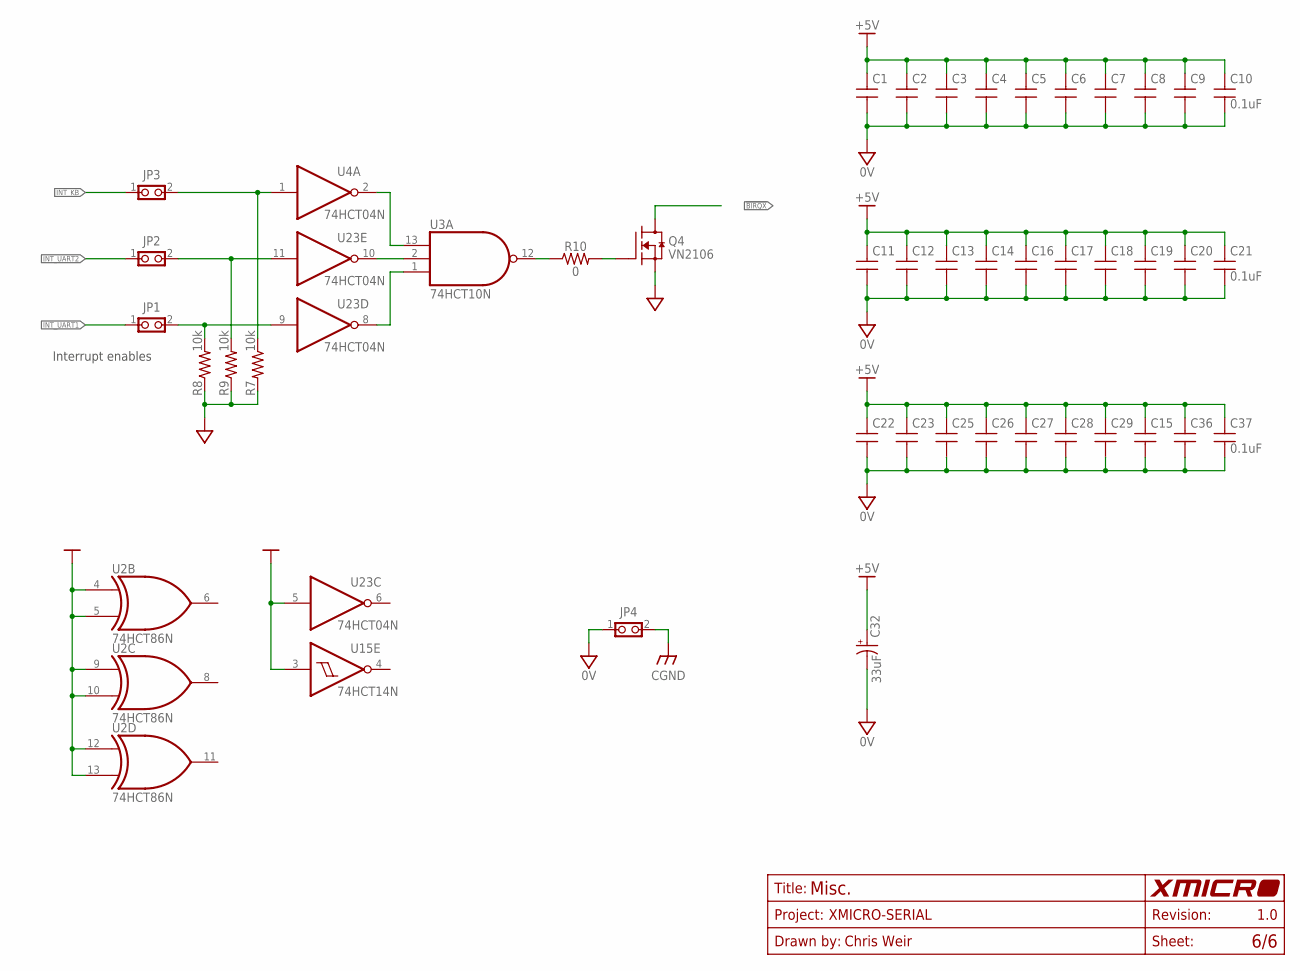
[picture p33: schematic XMICRO-SERIAL V1.0.sch, sheet 6, Misc.]

Parts:
C1, C2, C3, C4, C5, C6, C7, C8, C9, C10, C11, C12, C13, C14, C15, C16, C17, C18, C19, C20, C21, C22, C23, C25, C26, C27, C28, C29, C36, C37: 0.1uF; C025-024X044
C32: 33uF; E2,5-6
JP1, JP2, JP3, JP4: 1X2-THRU; 1X2
Q4: VN2106; TO92
R7, R8, R9: 10k; 0207/10
R10: 0; 0207/10
U2: 74HCT86N; DIL14
U3: 74HCT10N; DIL14
U4, U23: 74HCT04N; DIL14
U15: 74HCT14N; DIL14

Connections:
0V: C1.2, C2.2, C3.2, C4.2, C5.2, C6.2, C7.2, C8.2, C9.2, C10.2, C11.2, C12.2, C13.2, C14.2, C15.2, C16.2, C17.2, C18.2, C19.2, C20.2, C21.2, C22.2, C23.2, C25.2, C26.2, C27.2, C28.2, C29.2, C32.-, C36.2, C37.2, JP4.1, Q4.1 (S), R7.2, R8.1, R9.1, U2.7 (0V), U3.7 (0V), U4.7 (0V), U15.7 (0V), U23.7 (0V); also elsewhere on the board
!BIRQX: Q4.3 (D); also elsewhere on the board
+5V: C1.1, C2.1, C3.1, C4.1, C5.1, C6.1, C7.1, C8.1, C9.1, C10.1, C11.1, C12.1, C13.1, C14.1, C15.1, C16.1, C17.1, C18.1, C19.1, C20.1, C21.1, C22.1, C23.1, C25.1, C26.1, C27.1, C28.1, C29.1, C32.+, C36.1, C37.1, U2.4 (I0), U2.5 (I1), U2.9 (I0), U2.10 (I1), U2.12 (I0), U2.13 (I1), U2.14 (+5V), U3.14 (+5V), U4.14 (+5V), U15.3 (I), U15.14 (+5V), U23.5 (I), U23.14 (+5V); also elsewhere on the board
CGND: JP4.2; also elsewhere on the board
INT_KB: JP3.1; also elsewhere on the board
INT_UART1: JP1.1; also elsewhere on the board
INT_UART2: JP2.1; also elsewhere on the board
unnamed: R10.1, U3.12 (O)
unnamed: JP3.2, R7.1, U4.1 (I)
unnamed: U3.1 (I0), U23.8 (O)
unnamed: Q4.2 (G), R10.2
unnamed: U3.13 (I2), U4.2 (O)
unnamed: U3.2 (I1), U23.10 (O)
unnamed: JP1.2, R8.2, U23.9 (I)
unnamed: JP2.2, R9.2, U23.11 (I)

Notes on the sheet:
Interrupt enables

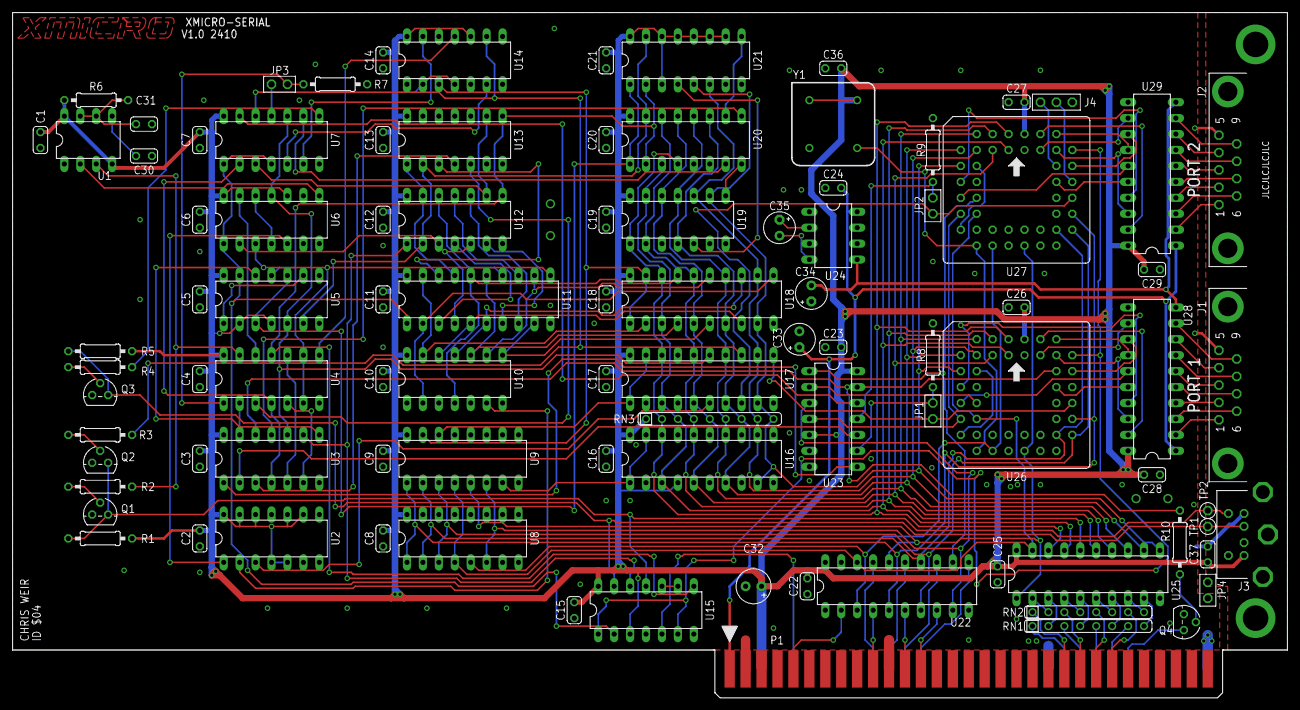
[picture p34: board XMICRO-SERIAL V1.0.brd from above]

Board: 2 copper layers, 203.2 x 109.2 mm, 95 parts (0 on the bottom side), 160 nets.
