X-Microsystems/xmicro-serial/Hardware/CAD/XMICRO-SERIAL V1.1.brd

## EAGLE design Hardware/CAD/XMICRO-SERIAL V1.1.brd (2019-11-20)

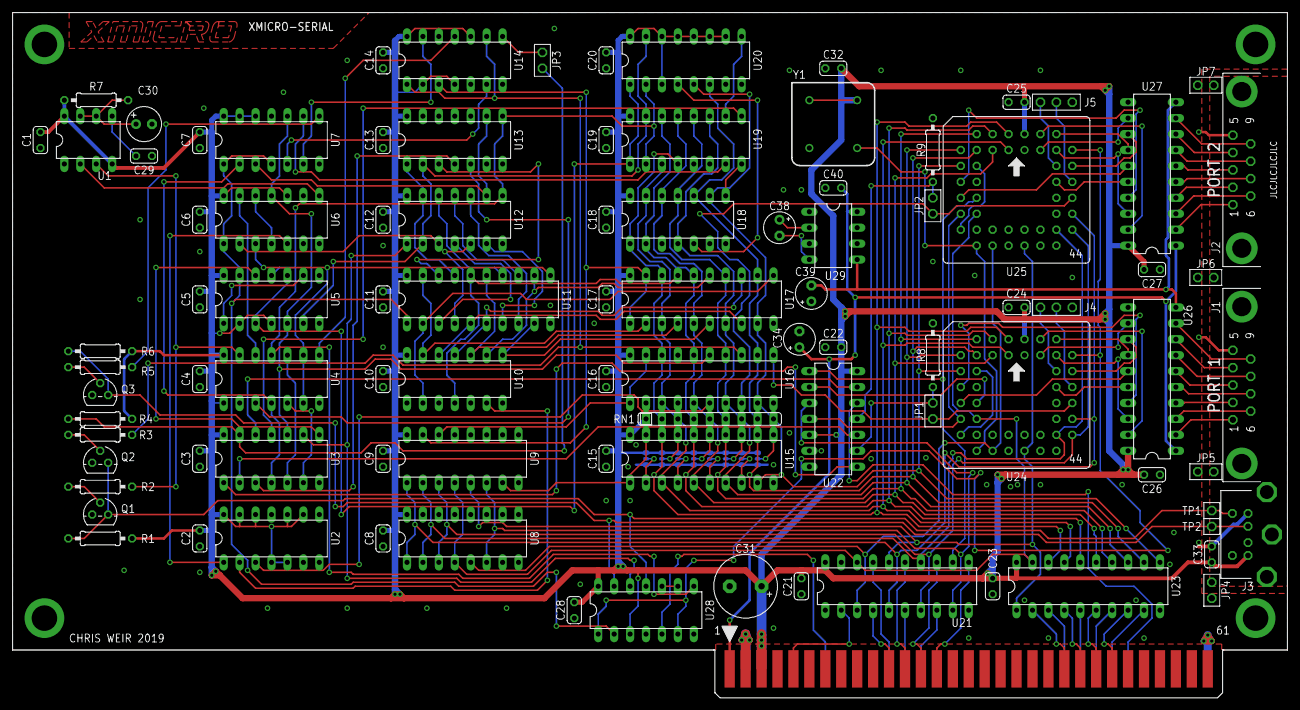
[picture p35: board XMICRO-SERIAL V1.1.brd from above]

Board: 2 copper layers, 203.2 x 109.2 mm, 95 parts (0 on the bottom side), 150 nets.

Parts:
C1, C2, C3, C4, C5, C6, C7, C8, C9, C10, C11, C12, C13, C14, C15, C16, C17, C18, C19, C20, C21, C22, C23, C24, C25, C26, C27, C28, C32, C33, C40: 0.1uF; C100
C29: 10nF; C100
C30: 0.1uF; E2,5-6
C31: 220uF; C-10-5
C34, C38, C39: 10uF; E2,5-5
CE0: XMICRO-BUS-EDGE62M; EDGE62M
J1, J2: D9-MPH; D9-H
J3: MINI-DIN6
J4, J5: PINHD1X3; 1X03
JP1, JP2, JP3, JP4, JP5, JP6, JP7: PINHD-1X2THRU; 1X02
Q1, Q2, Q3: 2N5088; TO92
R1, R4, R6, R8, R9: 10k; 0207/10
R2, R3, R5: 100k; 0207/10
R7: 1.2k; 0207/10
RN1: 10k; SIL9
TP1, TP2: PINHD-1X1; 1X01
U1: 555; DIL-08
U2: 7486; DIL14
U3: 7410; DIL14
U4, U22: 7404; DIL14
U5, U6, U14: 7474; DIL14
U7: 7408; DIL14
U8, U9: 74138; DIL16
U10, U18: 74280; DIL14
U11: 74273; DIL20
U12, U13: 74164; DIL14
U15, U16, U21: 74244; DIL20
U17: 74240; DIL20
U19, U20: 74165; DIL16
U23: 74245; DIL20
U24, U25: 16550; S44
U26, U27: 75185; DIL20
U28: 7414; DIL14
U29: TC962; DIL8
Y1: 1.8432MHz; DIL08S

Connections:
!BCSX: CE0.9, U21.2
!BRD: CE0.21, U21.4
!BRST: CE0.14, U28.5
!BWR: CE0.22, U21.17
!CSX: U8.4, U9.4, U21.18, U23.19, U24.16, U25.16
!CS_IDR: U9.7, U15.1, U15.19
!CS_KBR: U9.15, U14.3, U17.1, U17.19
!CS_KBW: U5.3, U5.10, U8.15, U19.1, U20.1
!CS_STR: U9.14, U16.1, U16.19
!INT_KB: JP3.1, U14.8
!IRQX: CE0.52, U22.12
!KB_DATA: U3.9, U12.1, U28.12
!KB_WRCYCLE: U5.6, U12.2, U13.2, U19.15, U20.15
!RD: U9.5, U21.16, U23.1, U24.24, U25.24
!RST: U5.13, U6.1, U7.1, U7.4, U11.1, U28.2
!WR: U8.5, U21.3, U24.20, U25.20
+12V: C34.+, C40.P$1, CE0.1, U26.1, U27.1, U29.8
-12V: C39.-, U26.10, U27.10, U29.5
A0: U8.1, U9.1, U21.5, U24.31, U25.31
A1: U8.2, U9.2, U21.14, U24.30, U25.30
A2: U8.3, U9.3, U21.7, U24.29, U25.29
A3: U21.12, U22.1, U25.14
A4: U8.6, U9.6, U21.9, U22.3
BA0: CE0.23, U21.15
BA1: CE0.24, U21.6
BA2: CE0.25, U21.13
BA3: CE0.26, U21.8
BA4: CE0.27, U21.11
BUFF_KB_CLOCK: U4.11, U5.11, U12.8, U13.8, U19.2, U20.2, U28.8
D0: RN1.2, U15.18, U16.18, U17.18, U18.1, U19.4, U23.18, U24.2, U25.2
D1: RN1.3, U15.3, U16.3, U17.3, U18.13, U19.3, U23.17, U24.3, U25.3
D2: RN1.4, U15.16, U16.16, U17.16, U18.2, U19.14, U23.16, U24.4, U25.4
D3: RN1.5, U15.5, U16.5, U17.5, U18.12, U19.13, U23.15, U24.5, U25.5
D4: RN1.6, U15.14, U16.14, U17.14, U18.11, U19.12, U23.14, U24.6, U25.6
D5: RN1.7, U15.7, U16.7, U17.7, U18.4, U19.11, U23.13, U24.7, U25.7
D6: RN1.8, U15.12, U16.12, U17.12, U18.10, U20.6, U23.12, U24.8, U25.8
D7: RN1.9, U15.9, U16.9, U17.9, U18.9, U20.5, U23.11, U24.9, U25.9
GND: C1.P$2, C2.P$2, C3.P$2, C4.P$2, C5.P$2, C6.P$2, C7.P$2, C8.P$2, C9.P$2, C10.P$2, C11.P$2, C12.P$2, C13.P$2, C14.P$2, C15.P$2, C16.P$2, C17.P$2, C18.P$2, C19.P$2, C20.P$2, C21.P$2, C22.P$2, C23.P$2, C24.P$2, C25.P$2, C26.P$2, C27.P$2, C28.P$2, C29.P$2, C30.-, C31.-, C32.P$2, C33.P$2, C34.-, C39.+, C40.P$2, CE0.3, CE0.4, CE0.62, J1.P$5, J2.P$5, J3.3, J4.3, J5.3, JP4.1, JP5.1, JP6.1, JP7.1, Q1.1, Q2.1, Q3.1, R8.1, R9.1, U1.1, U2.7, U3.7, U4.7, U5.7, U6.7, U7.7, U8.8, U9.8, U10.1, U10.7, U11.10, U12.7, U13.7, U14.7, U15.10, U16.2, U16.4, U16.10, U16.17, U17.10, U18.7, U18.8, U19.5, U19.6, U19.8, U20.8, U21.1, U21.10, U21.19, U22.7, U23.10, U24.21, U24.22, U24.25, U24.28, U25.21, U25.22, U25.25, U25.28, U26.11, U27.11, U28.7, U29.3, Y1.4
INT_KB: R3.1, U14.1, U14.9, U16.13
INT_UART1: JP1.1, U16.11, U24.33
INT_UART2: JP2.1, U16.8, U25.33
KB_CLOCK: J3.5, Q1.3, Q2.3, R1.1, TP1.1, U28.11
KB_DATA: J3.1, Q3.3, R6.1, TP2.1, U28.13
KB_ERR: U2.3, U16.6
KB_WRCYCLE: U3.10, U5.5, U6.11, U7.10, U16.15
unnamed: J1.P$1, U26.2
unnamed: J1.P$2, U26.4
unnamed: J1.P$3, U26.6
unnamed: J1.P$4, U26.8
unnamed: J1.P$6, U26.3
unnamed: J1.P$7, U26.5
unnamed: J1.P$8, U26.7
unnamed: J1.P$9, U26.9
unnamed: J2.P$1, U27.2
unnamed: U24.43, U26.12
unnamed: U24.37, U26.13
unnamed: U24.40, U26.14
unnamed: U24.13, U26.15
unnamed: U24.36, U26.16
unnamed: U24.11, U26.17
unnamed: U24.41, U26.18
unnamed: U24.42, U26.19
unnamed: U24.10, U24.17
unnamed: U3.6, U4.5
unnamed: U4.8, U14.11
unnamed: U3.12, U22.13
unnamed: U3.8, U5.12
unnamed: U4.12, U6.13
unnamed: JP3.2, R4.1, U3.13
unnamed: U3.1, U22.8
unnamed: U28.9, U28.10
unnamed: C38.-, U29.4
unnamed: J2.P$2, U27.4
unnamed: J2.P$3, U27.6
unnamed: J2.P$4, U27.8
unnamed: J2.P$6, U27.3
unnamed: J2.P$7, U27.5
unnamed: CE0.50, U23.9
unnamed: CE0.49, U23.8
unnamed: CE0.48, U23.7
unnamed: CE0.47, U23.6
unnamed: CE0.46, U23.5
unnamed: CE0.45, U23.4
unnamed: CE0.44, U23.3
unnamed: CE0.43, U23.2
unnamed: J2.P$8, U27.7
unnamed: J2.P$9, U27.9
unnamed: C38.+, U29.2
unnamed: U25.43, U27.12
unnamed: U25.37, U27.13
unnamed: U25.40, U27.14
unnamed: U25.13, U27.15
unnamed: U25.36, U27.16
unnamed: U25.11, U27.17
unnamed: U25.41, U27.18
unnamed: U25.42, U27.19
unnamed: U25.10, U25.17
unnamed: U11.17, U12.13, U13.1
unnamed: U11.18, U13.3
unnamed: U4.3, U13.5
unnamed: U3.4, U4.4, U7.2
unnamed: U4.6, U4.9, U6.3, U11.11
unnamed: U3.3, U13.4
unnamed: U11.14, U12.12
unnamed: U11.13, U12.11
unnamed: U11.7, U12.6
unnamed: U11.4, U12.5
unnamed: U11.3, U12.4
unnamed: U6.2, U12.3
unnamed: U7.3, U12.9, U13.9
unnamed: U7.6, U14.13
unnamed: U2.1, U6.5
unnamed: U10.13, U11.19, U17.2
unnamed: U3.11, U19.9
unnamed: U10.4, U11.16, U17.17
unnamed: U10.10, U11.15, U17.4
unnamed: U10.9, U11.12, U17.15
unnamed: U10.11, U11.6, U17.13
unnamed: U10.12, U11.5, U17.8
unnamed: U10.2, U11.2, U17.11
unnamed: U10.8, U11.9, U17.6
unnamed: U7.9, U19.7
unnamed: U2.2, U10.6
unnamed: U3.5, U4.10
unnamed: R5.1, U7.8
unnamed: Q2.2, R3.2
unnamed: U3.2, U22.10
unnamed: U7.5, U14.6
unnamed: U19.10, U20.9
unnamed: U22.2, U24.14
unnamed: U22.4, U24.15, U25.15
unnamed: JP1.2, R8.2, U22.9
unnamed: U24.18, U25.18, Y1.5
unnamed: JP2.2, R9.2, U22.11
unnamed: U18.5, U20.4
unnamed: J5.1, U25.38
unnamed: J5.2, U25.35
unnamed: Q3.2, R5.2
unnamed: J4.1, U24.38
unnamed: Q1.2, R2.2
unnamed: U5.1, U5.9
unnamed: U1.2, U6.8
unnamed: C30.+, R7.2, U1.6, U1.7
unnamed: J4.2, U24.35
unnamed: R2.1, U1.3, U4.13
unnamed: C29.P$1, U1.5
RST: U24.39, U25.39, U28.1, U28.6
SHIELD: J1.S1, J1.S2, J2.S1, J2.S2, J3.G$1, J3.G$2, J3.G$3, JP4.2, JP5.2, JP6.2, JP7.2
UC4: U11.8, U12.10
VCC: C1.P$1, C2.P$1, C3.P$1, C4.P$1, C5.P$1, C6.P$1, C7.P$1, C8.P$1, C9.P$1, C10.P$1, C11.P$1, C12.P$1, C13.P$1, C14.P$1, C15.P$1, C16.P$1, C17.P$1, C18.P$1, C19.P$1, C20.P$1, C21.P$1, C22.P$1, C23.P$1, C24.P$1, C25.P$1, C26.P$1, C27.P$1, C28.P$1, C31.+, C32.P$1, C33.P$1, CE0.5, CE0.6, J3.4, R1.2, R4.2, R6.2, R7.1, RN1.1, U1.4, U1.8, U2.4, U2.5, U2.9, U2.10, U2.12, U2.13, U2.14, U3.14, U4.1, U4.14, U5.2, U5.4, U5.14, U6.4, U6.10, U6.12, U6.14, U7.12, U7.13, U7.14, U8.16, U9.16, U10.14, U11.20, U12.14, U13.14, U14.2, U14.4, U14.10, U14.12, U14.14, U15.20, U16.20, U17.20, U18.14, U19.16, U20.3, U20.10, U20.11, U20.12, U20.13, U20.14, U20.16, U21.20, U22.5, U22.14, U23.20, U24.44, U25.44, U26.20, U27.20, U28.3, U28.14, Y1.1, Y1.8
