X-Microsystems/xmicro-serial/(commit log)

2019-03-23 Reogranized directory structure
    [XMICRO-SERIAL V1.1 BOM.csv, XMICRO-SERIAL V1.1.brd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]
2019-05-28 Updated schematic xrefs to indicate signal direction.
    [XMICRO-SERIAL V1.1.sch]
2019-10-27 Updated design to V1.1 - added Schmitt trigger inputs, improved connector spacing, fixed PS/2 connector footprint
    [XMICRO-SERIAL V1.1 BOM.csv, XMICRO-SERIAL V1.1.brd, XMICRO-SERIAL V1.1.sch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]
2019-10-27 Fixed a schematic issue - added second inverter to BUFF_KB_CLOCK signal.
    [XMICRO-SERIAL V1.1 BOM.csv, XMICRO-SERIAL V1.1.brd, XMICRO-SERIAL V1.1.sch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]
2019-11-20 Updated to hardware V1.1.
    [XMICRO-SERIAL V1.1 BOM.csv, XMICRO-SERIAL V1.1.brd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]
2024-09-09 Initial commit for finalized V1.0
    [BOM.csv, XMICRO-SERIAL Shield V1.0.brd, XMICRO-SERIAL V1.0.brd, XMICRO-SERIAL V1.0.sch, XMICRO-SERIAL V1.1 BOM.csv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]
